Gninnorg/ThePreamp/Hardware/Controller/ThePreamp-Controller.jpg

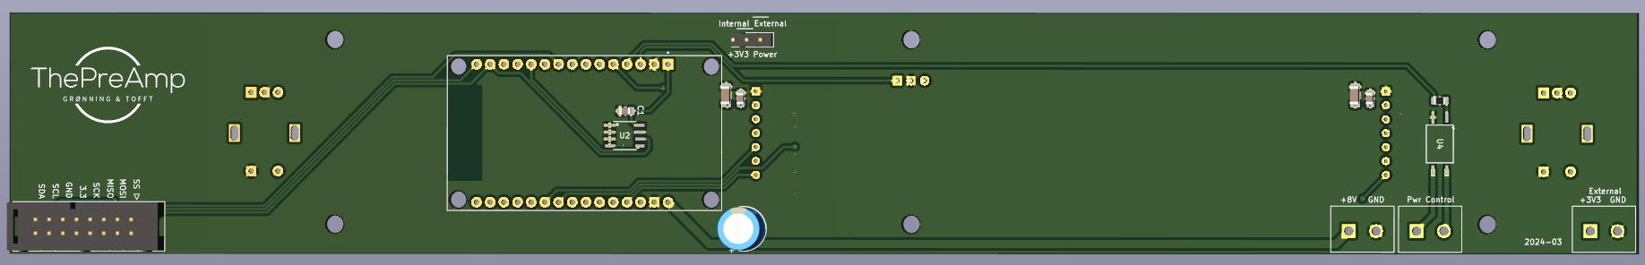
Hardware/Controller/ThePreamp-Controller.jpg
