Gninnorg/ThePreamp/Hardware/Analogue/ThePreamp-Analogue.jpg

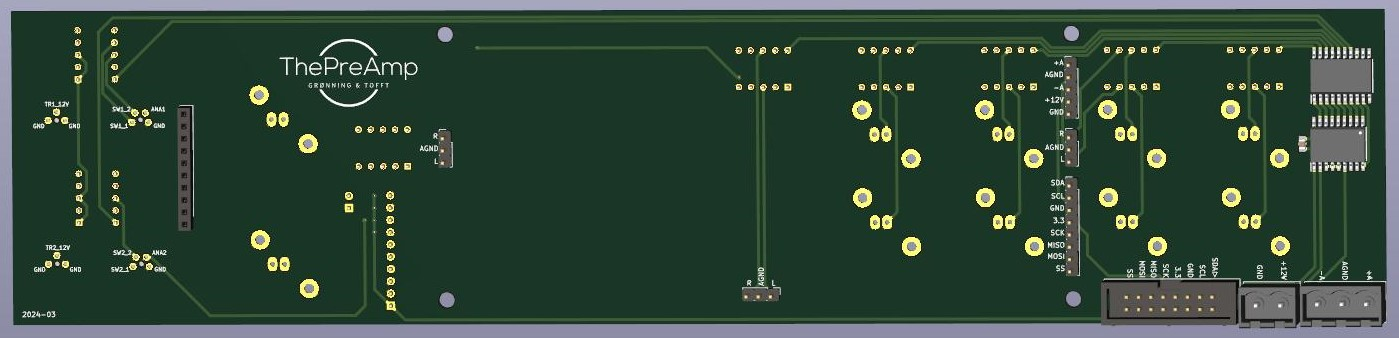
Hardware/Analogue/ThePreamp-Analogue.jpg
