Gninnorg/ThePreamp/Hardware/ThePreAmp.png

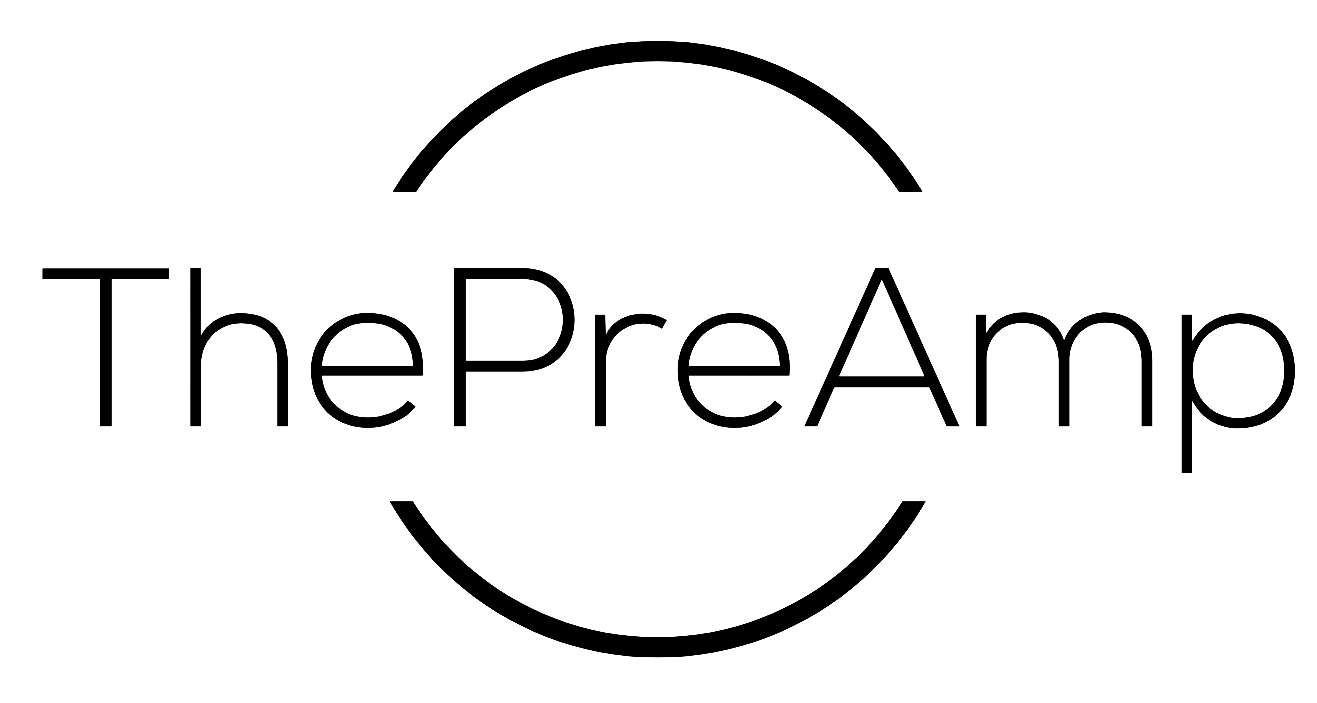
Hardware/ThePreAmp.png
