Gninnorg/ThePreamp/Software/ThePreAmp wifi QR BIG.bmp

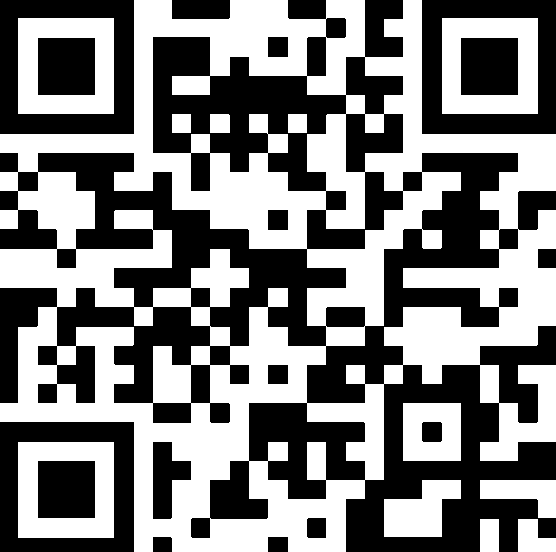
Software/ThePreAmp wifi QR BIG.bmp
