Gninnorg/ThePreamp/Software/Webpages/ThePreAmp.png

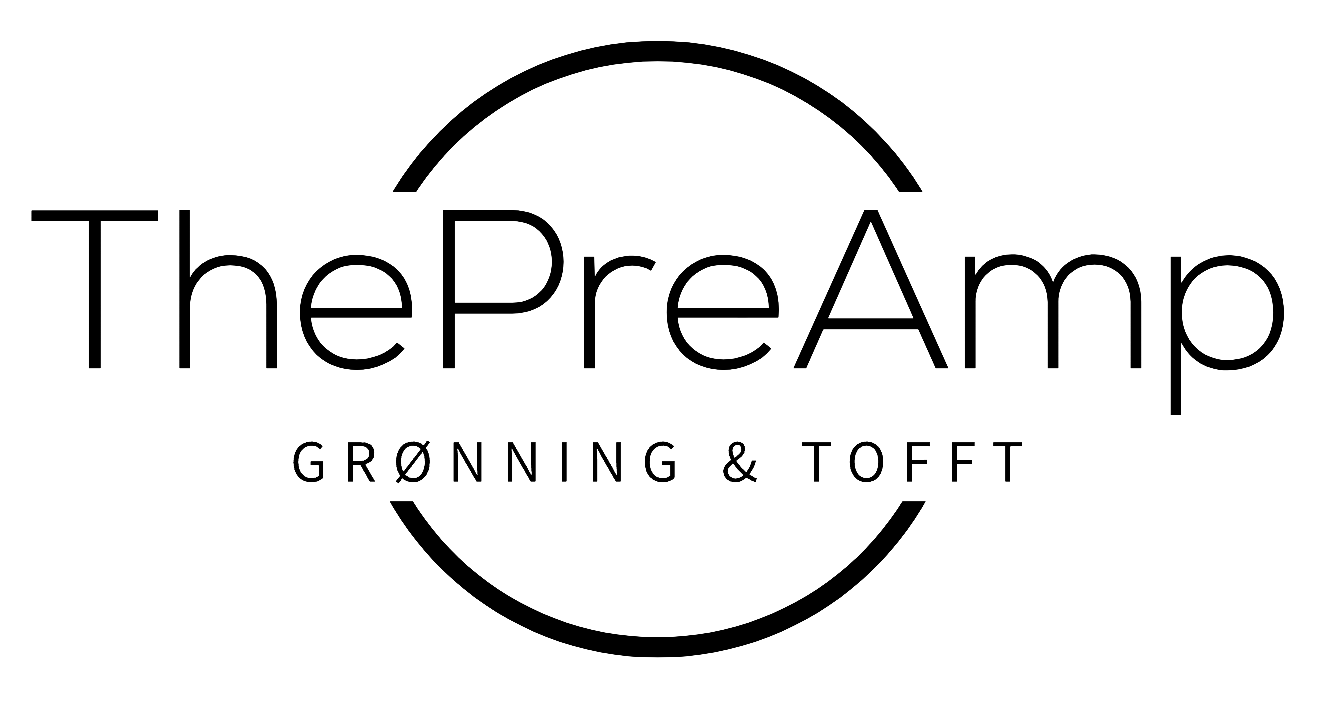
Software/Webpages/ThePreAmp.png
