Gninnorg/ThePreamp/Hardware/Analogue/THE_PREAMP_CONN_POWER_5_08/TBP01R1-508-02BK/BOM.txt

3DX_CUI_DEVICES_Supplier: CUI Devices
3DX_CUI_DEVICES_Part Number: TBP01R1-508-02BK
3DX_CUI_DEVICES_Description: TBP01R1-508 Series - 2 Poles, Pluggable, Receptacle, Horizontal, 5.08 Pitch, Terminal Block Connector, RoHS Compliant
