Gninnorg/ThePreamp/Hardware/Analogue/THE_PREAMP_CONN_POWER_5_08/TBP01R2-508-03BK/BOM.txt

3DX_CUI_DEVICES_Supplier: CUI Devices
3DX_CUI_DEVICES_Part Number: TBP01R2-508-03BK
3DX_CUI_DEVICES_Description: TBP01R2-508 Series - 3 Poles, Pluggable, Receptacle, Vertical, 5.08 Pitch, Terminal Block Connector, RoHS Compliant
