Gninnorg/ThePreamp/Hardware/Analogue/EA2-12NJ/EA2-12NJ.step

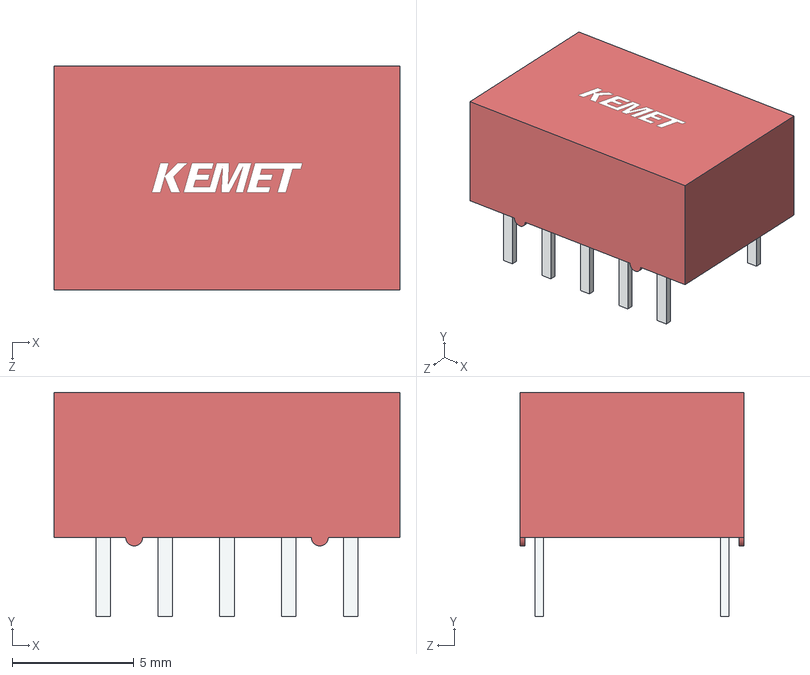
[picture p7: CAD file, 2024-02-28]
Hardware/Analogue/EA2-12NJ/EA2-12NJ.step
14.2 x 9.20 x 9.20 mm
