Gninnorg/ThePreamp/Hardware/Analogue/RCA_CONNECTOR_ALI/RCA Connector ALI.step

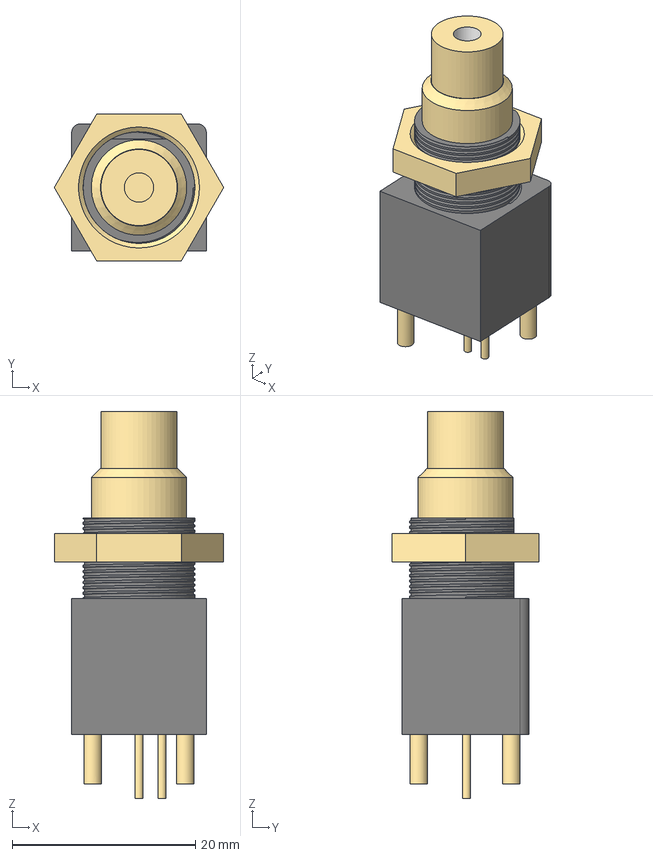
[picture p8: CAD file, 2024-03-03]
Hardware/Analogue/RCA_CONNECTOR_ALI/RCA Connector ALI.step
18.5 x 16.0 x 42.2 mm
