Gninnorg/ThePreamp/Hardware/Analogue/THE_PREAMP_CONN_POWER_5_08/TBP01R1-508-03BK/CUI_DEVICES_TBP01R1-508-03BK.step

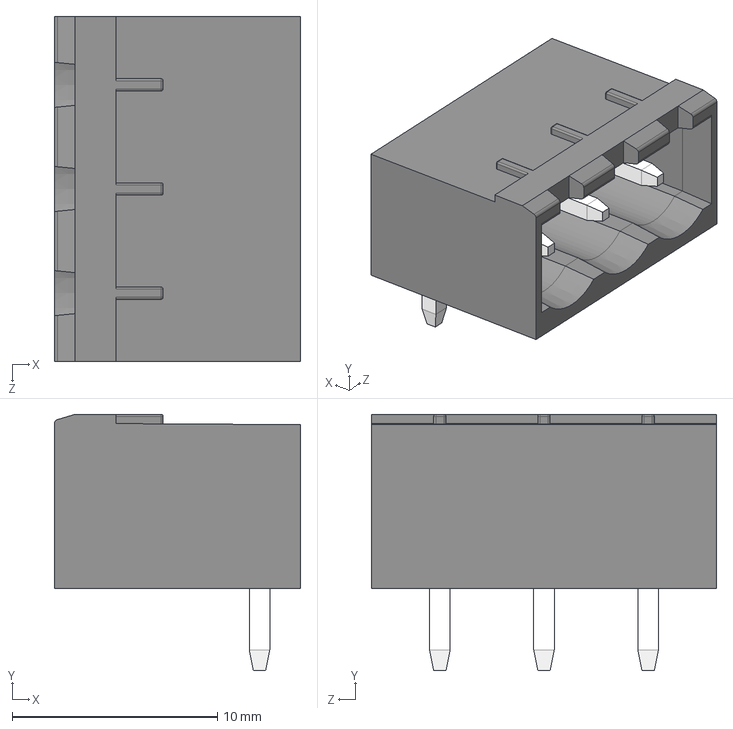
[picture p9: CAD file, 2024-02-27]
Hardware/Analogue/THE_PREAMP_CONN_POWER_5_08/TBP01R1-508-03BK/CUI_DEVICES_TBP01R1-508-03BK.step
12.0 x 12.5 x 16.8 mm
