Gninnorg/ThePreamp/Hardware/Analogue/THE_PREAMP_CONN_POWER_5_08/TBP01R2-508-03BK/CUI_DEVICES_TBP01R2-508-03BK.step

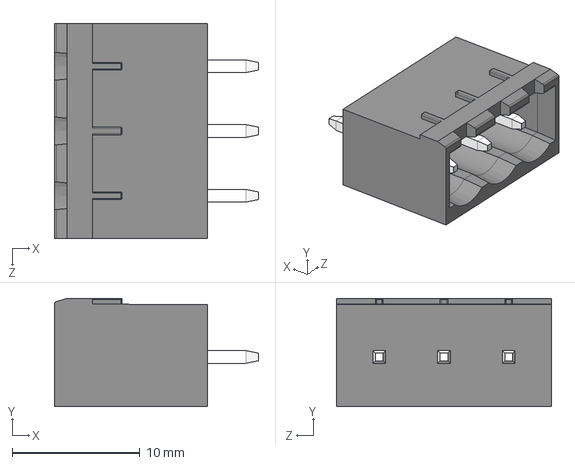
[picture p11: CAD file, 2024-02-27]
Hardware/Analogue/THE_PREAMP_CONN_POWER_5_08/TBP01R2-508-03BK/CUI_DEVICES_TBP01R2-508-03BK.step
16.0 x 8.50 x 16.8 mm
