Gninnorg/ThePreamp/Hardware/Analogue/ULN2803/ULN2803CDWR.STEP

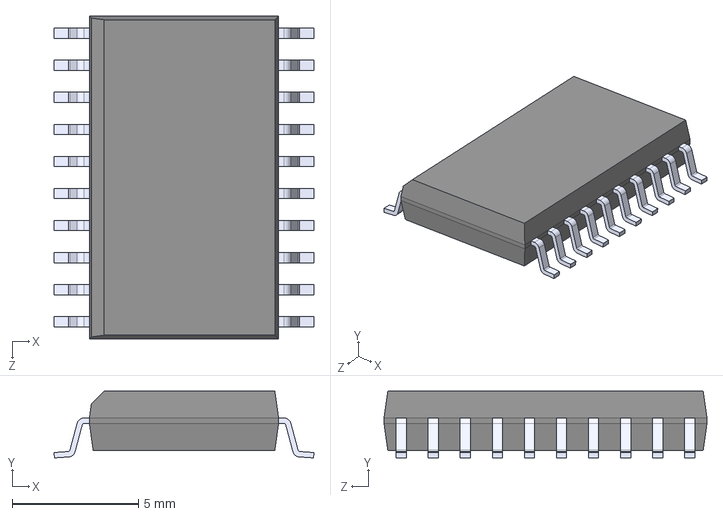
[picture p12: CAD file, 2024-02-28]
Hardware/Analogue/ULN2803/ULN2803CDWR.STEP
10.3 x 2.65 x 12.8 mm
