Gninnorg/ThePreamp/Hardware/Controller/EEE_FH1C471L/EEEFH1C471L.step

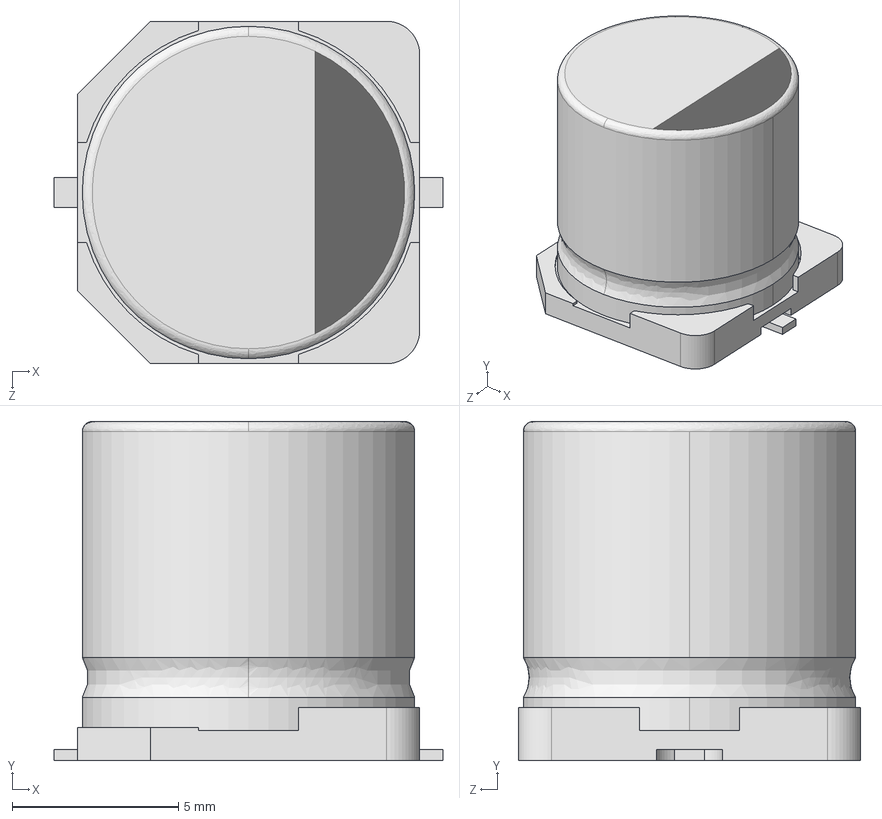
[picture p13: CAD file, 2024-02-11]
Hardware/Controller/EEE_FH1C471L/EEEFH1C471L.step
11.7 x 10.2 x 10.3 mm
