Gninnorg/ThePreamp/Hardware/Controller/PEC11R-4220F-S0024/PEC11r-4220f-s0024.stp

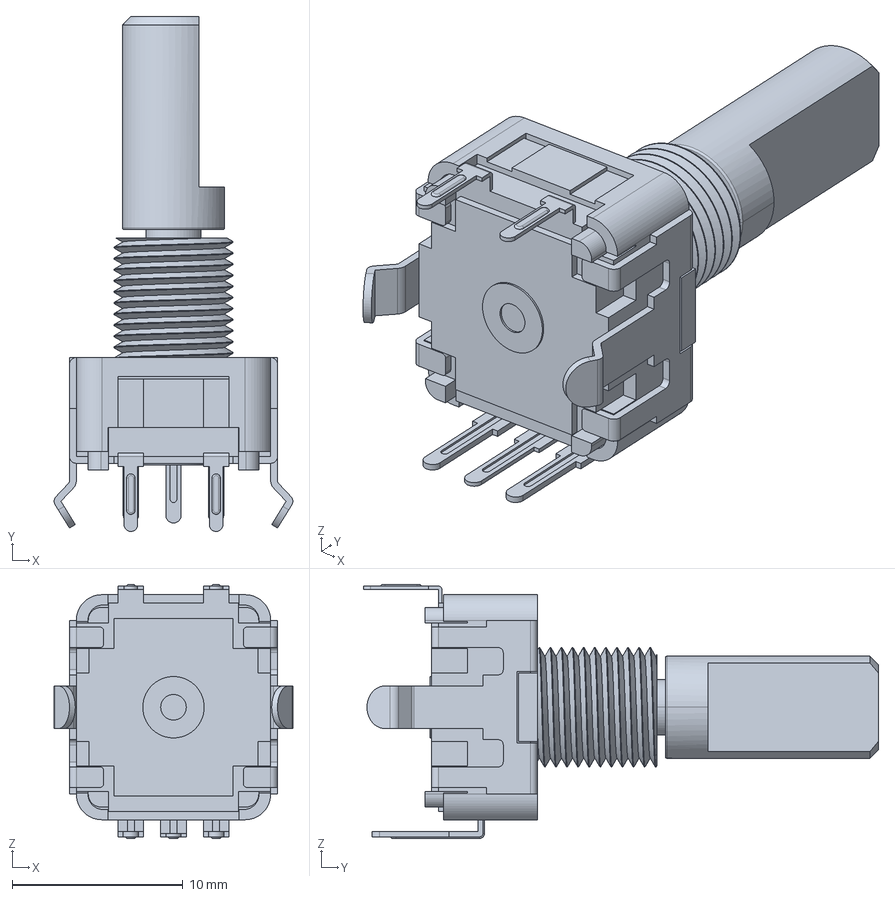
[picture p14: CAD file, 2024-03-03]
Hardware/Controller/PEC11R-4220F-S0024/PEC11r-4220f-s0024.stp
14.0 x 30.2 x 14.9 mm
