Gninnorg/ThePreamp/Hardware/Analogue/M8 connector/M8 3 pin/c-t4040014031-000-a-3d.stp

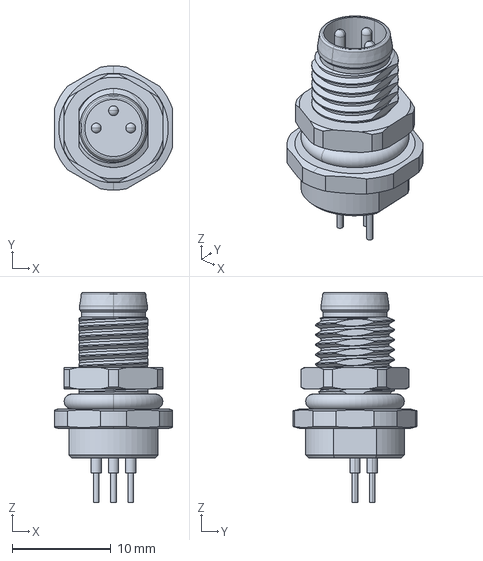
[picture p15: CAD file, 2024-02-28]
Hardware/Analogue/M8 connector/M8 3 pin/c-t4040014031-000-a-3d.stp
12.0 x 12.6 x 21.3 mm
