Gninnorg/ThePreamp/Hardware/Analogue/MCP23008/MCP23008-E_SO.step

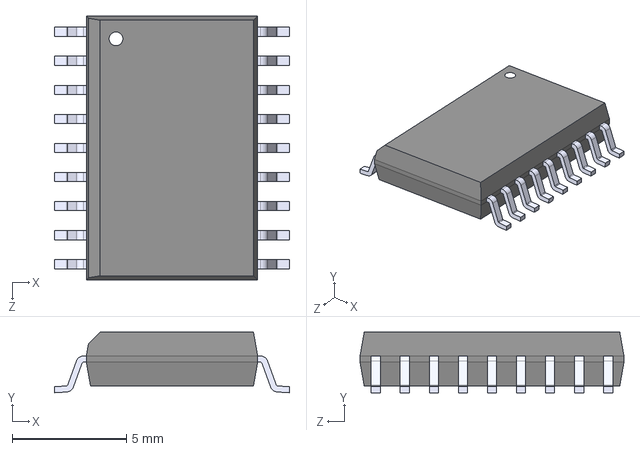
[picture p17: CAD file, 2024-02-28]
Hardware/Analogue/MCP23008/MCP23008-E_SO.step
10.3 x 2.65 x 11.5 mm
