Gninnorg/ThePreamp/Software/ThePreamp Controller/test/README

This directory is intended for PlatformIO Test Runner and project tests.

Unit Testing is a software testing method by which individual units of
source code, sets of one or more MCU program modules together with associated
control data, usage procedures, and operating procedures, are tested to
determine whether they are fit for use. Unit testing finds problems early
in the development cycle.

More information about PlatformIO Unit Testing:
- https://docs.platformio.org/en/latest/advanced/unit-testing/index.html

TO DO

Test IR - PASSED
Test rotary encoders - PASSED
Test SPI on analogue board (Muses) - PASSED
Test triggers 12V + Switch

IMPORTANT:
The SPI frequency for the SH1122 displays must be changed in u8x8_d_sh1122.c to 20000000 Hz:

static const u8x8_display_info_t u8x8_sh1122_256x64_display_info =
{
  /* chip_enable_level = */ 0,
  /* chip_disable_level = */ 1,
  
  /* post_chip_enable_wait_ns = */ 20,
  /* pre_chip_disable_wait_ns = */ 10,
  /* reset_pulse_width_ms = */ 10, 	/* sh1122: 10 us */
  /* post_reset_wait_ms = */ 20, 	/* */
  /* sda_setup_time_ns = */ 125,		/* sh1122: cycle time is 250ns, so use 250/2 */
  /* sck_pulse_width_ns = */ 125,	/* sh1122: cycle time is 250ns, so use 250/2 */
  /* sck_clock_hz = */ 20000000UL,	/* since Arduino 1.6.0, the SPI bus speed in Hz. Should be  1000000000/sck_pulse_width_ns  */
  /* spi_mode = */ 0,		/* active high, rising edge */
  /* i2c_bus_clock_100kHz = */ 4,
  /* data_setup_time_ns = */ 10,
  /* write_pulse_width_ns = */ 150,	/* sh1122: cycle time is 300ns, so use 300/2 = 150 */
  /* tile_width = */ 32,		/* 256 pixel, so we require 32 bytes for this */
  /* tile_height = */ 8,
  /* default_x_offset = */ 0,	/* this is the byte offset (there are two pixel per byte with 4 bit per pixel) */
  /* flipmode_x_offset = */ 0,
  /* pixel_width = */ 256,
  /* pixel_height = */ 64
};
