Gninnorg/ThePreamp/Hardware/Controller/ThePreamp-Controller.kicad_pcb

## KiCad design Hardware/Controller/ThePreamp-Controller.kicad_pcb (2026-02-25)

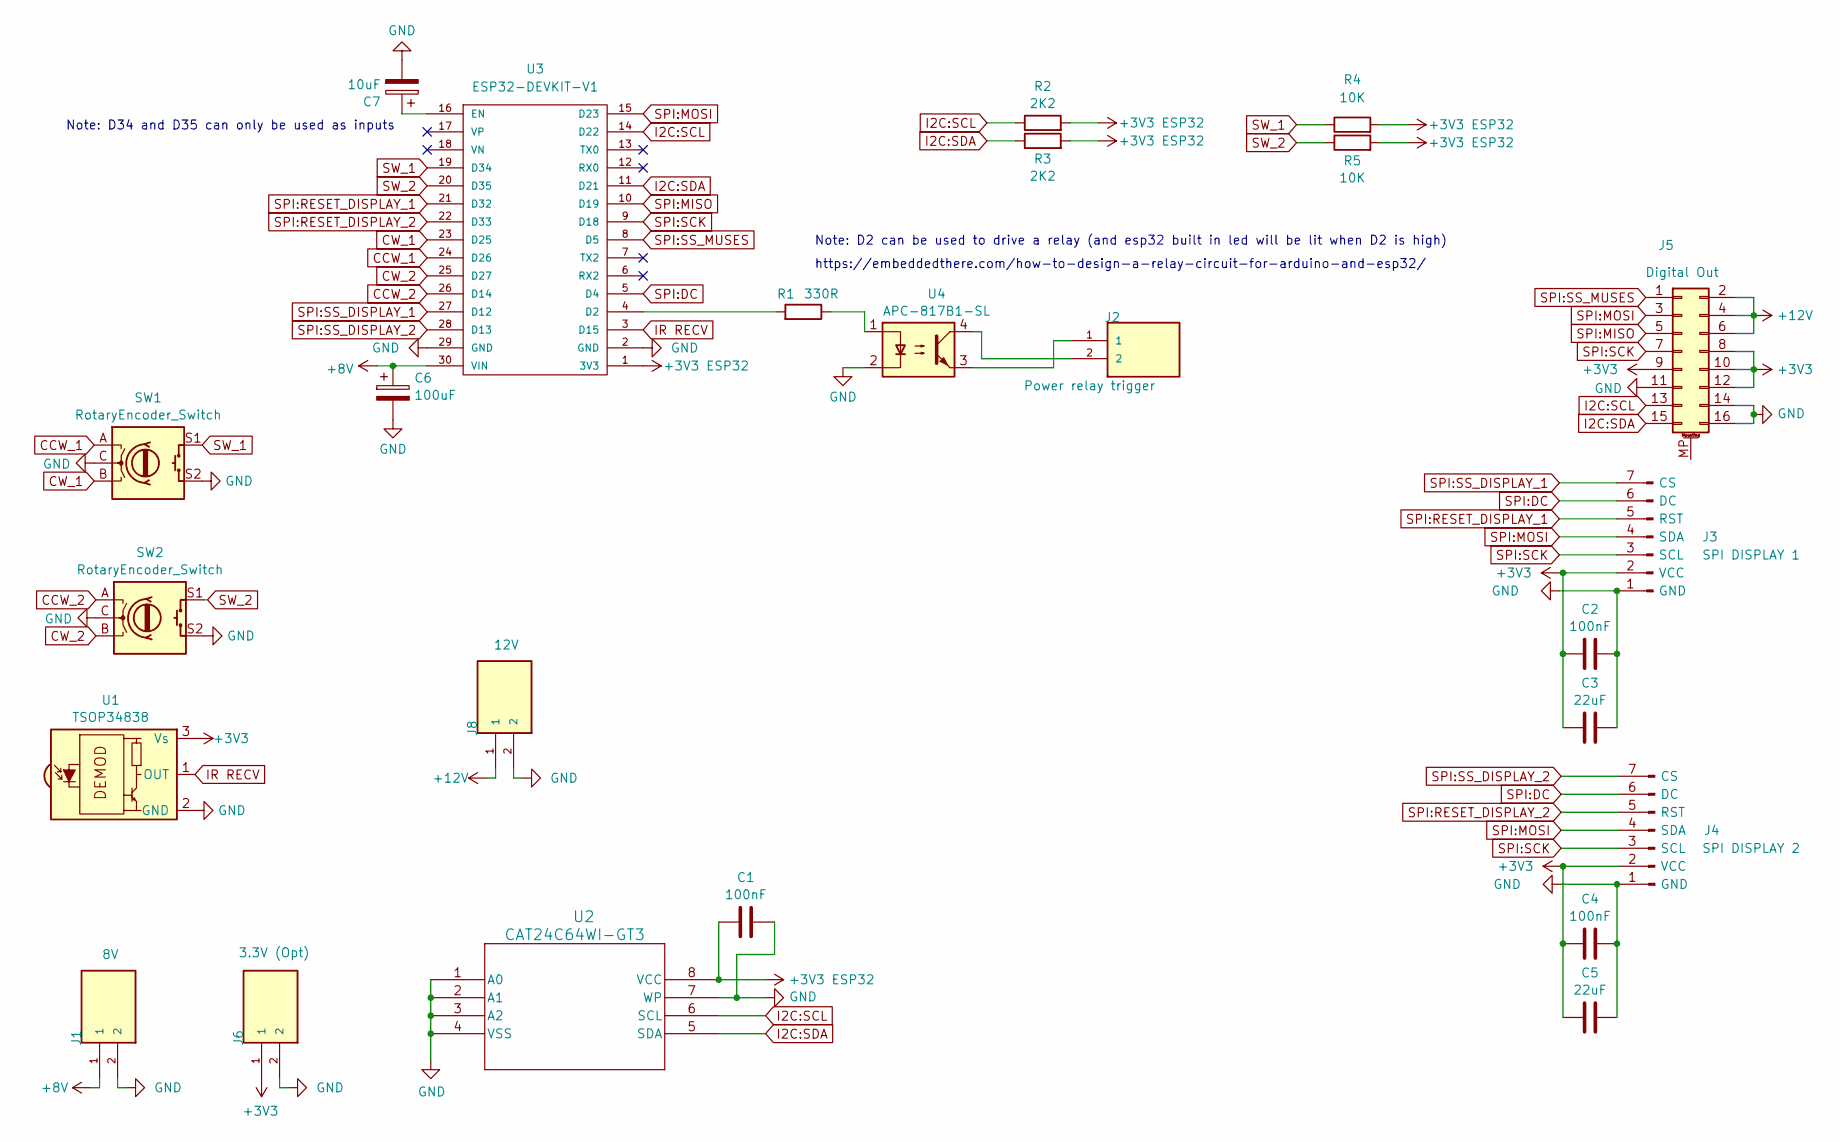
[picture p18: schematic ThePreamp-Controller.kicad_sch]

Parts:
C1, C2, C4: 100nF; C_0805_2012Metric_Pad1.18x1.45mm_HandSolder
C3, C5: 22uF; C_1206_3216Metric_Pad1.33x1.80mm_HandSolder
C6: 100uF; CP_Radial_D8.0mm_P3.50mm
C7: 10uF; CP_Radial_D8.0mm_P3.50mm
J1: 8V; TBP01R2-508-02BK (VERT)
J2: Power relay trigger; TBP01R2-508-02BK (VERT)
J3: SPI DISPLAY 1; OLED SPI 2.08
J4: SPI DISPLAY 2; OLED SPI 2.08
J5: Digital Out; IDC-Header_2x08_P2.54mm_Vertical
J6: 3.3V (Opt); TBP01R2-508-02BK (VERT)
J8: 12V; TBP01R2-508-02BK (VERT)
R1: 330R; R_0805_2012Metric_Pad1.20x1.40mm_HandSolder
R2, R3: 2K2; R_0805_2012Metric_Pad1.20x1.40mm_HandSolder
R4, R5: 10K; R_0805_2012Metric_Pad1.20x1.40mm_HandSolder
SW1, SW2: RotaryEncoder_Switch; RotaryEncoder_Alps_EC11E-Switch_Vertical_H20mm
U1: TSOP34838; Vishay_MOLD-3Pin
U2: CAT24C64WI-GT3; SOIC8_ONS-M
U3: ESP32-DEVKIT-V1; MODULE_ESP32_DEVKIT_V1; PARTREV N/A
U4: APC-817B1-SL; APC-817xx-SL_AMB-M

Connections:
+3V3: C2.1, C3.1, C4.1, C5.1, J3.2 (VCC), J4.2 (VCC), J5.8, J5.9, J5.10, J5.12, J6.1, U1.3 (Vs)
+3V3 ESP32: C1.1, R2.2, R3.2, R4.2, R5.2, U2.8 (VCC), U3.1 (3V3)
+8V: C6.1, J1.1, U3.30 (VIN)
+12V: J5.2, J5.4, J5.6, J8.1
CCW_1: SW1.A, U3.24 (D26)
CCW_2: SW2.A, U3.26 (D14)
CW_1: SW1.B, U3.23 (D25)
CW_2: SW2.B, U3.25 (D27)
GND: C1.2, C2.2, C3.2, C4.2, C5.2, C6.2, C7.2, J1.2, J3.1 (GND), J4.1 (GND), J5.11, J5.14, J5.16, J6.2, J8.2, SW1.C, SW1.S2, SW2.C, SW2.S2, U1.2 (GND), U2.1 (A0), U2.2 (A1), U2.3 (A2), U2.4 (VSS), U2.7 (WP), U3.2 (GND), U3.29 (GND), U4.2
I2C:SCL: J5.13, R2.1, U2.6 (SCL), U3.14 (D22)
I2C:SDA: J5.15, R3.1, U2.5 (SDA), U3.11 (D21)
IR RECV: U1.1 (OUT), U3.3 (D15)
unnamed: J2.1, U4.3
unnamed: J2.2, U4.4
unnamed: R1.1, U4.1
unnamed: R1.2, U3.4 (D2)
unnamed: C7.1, U3.16 (EN)
SPI:DC: J3.6 (DC), J4.6 (DC), U3.5 (D4)
SPI:MISO: J5.5, U3.10 (D19)
SPI:MOSI: J3.4 (SDA), J4.4 (SDA), J5.3, U3.15 (D23)
SPI:RESET_DISPLAY_1: J3.5 (RST), U3.21 (D32)
SPI:RESET_DISPLAY_2: J4.5 (RST), U3.22 (D33)
SPI:SCK: J3.3 (SCL), J4.3 (SCL), J5.7, U3.9 (D18)
SPI:SS_DISPLAY_1: J3.7 (CS), U3.27 (D12)
SPI:SS_DISPLAY_2: J4.7 (CS), U3.28 (D13)
SPI:SS_MUSES: J5.1, U3.8 (D5)
SW_1: R4.1, SW1.S1, U3.19 (D34)
SW_2: R5.1, SW2.S1, U3.20 (D35)

Notes on the sheet:
Note: D34 and D35 can only be used as inputs
https://embeddedthere.com/how-to-design-a-relay-circuit-for-arduino-and-esp32/
Note: D2 can be used to drive a relay (and esp32 built in led will be lit when D2 is high)

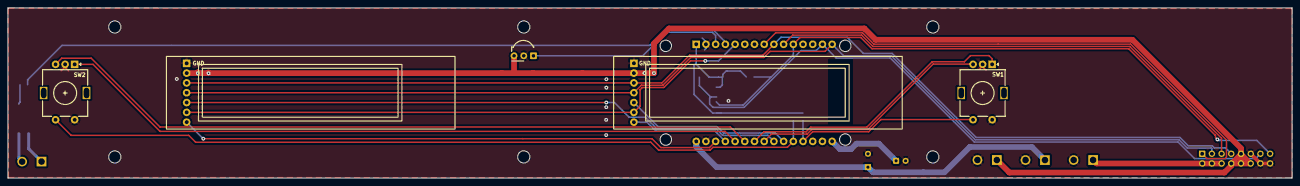
[picture p19: board ThePreamp-Controller.kicad_pcb from above]

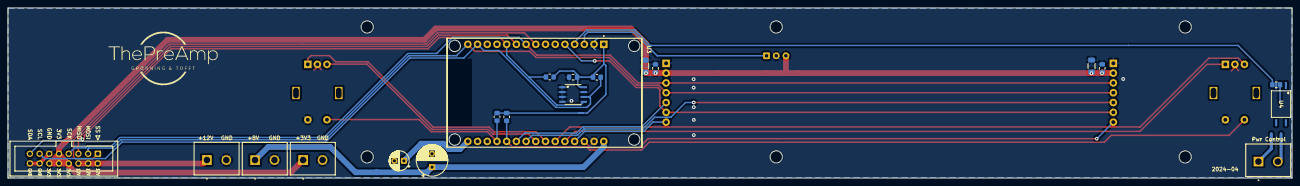
[picture p20: board ThePreamp-Controller.kicad_pcb from below]

Board: 2 copper layers, 335.9 x 44.5 mm, 31 parts (20 on the bottom side), 28 nets.

Other parts of the board:
 : MountingHole_3.2mm_M3_ISO7380
 #2,  #3,  #4,  #5,  #6: MountingHole_3.2mm_M3_ISO7380
