Gninnorg/ThePreamp/Hardware/Analogue/ThePreamp-Analogue.kicad_pcb

## KiCad design Hardware/Analogue/ThePreamp-Analogue.kicad_pcb (2026-02-15)

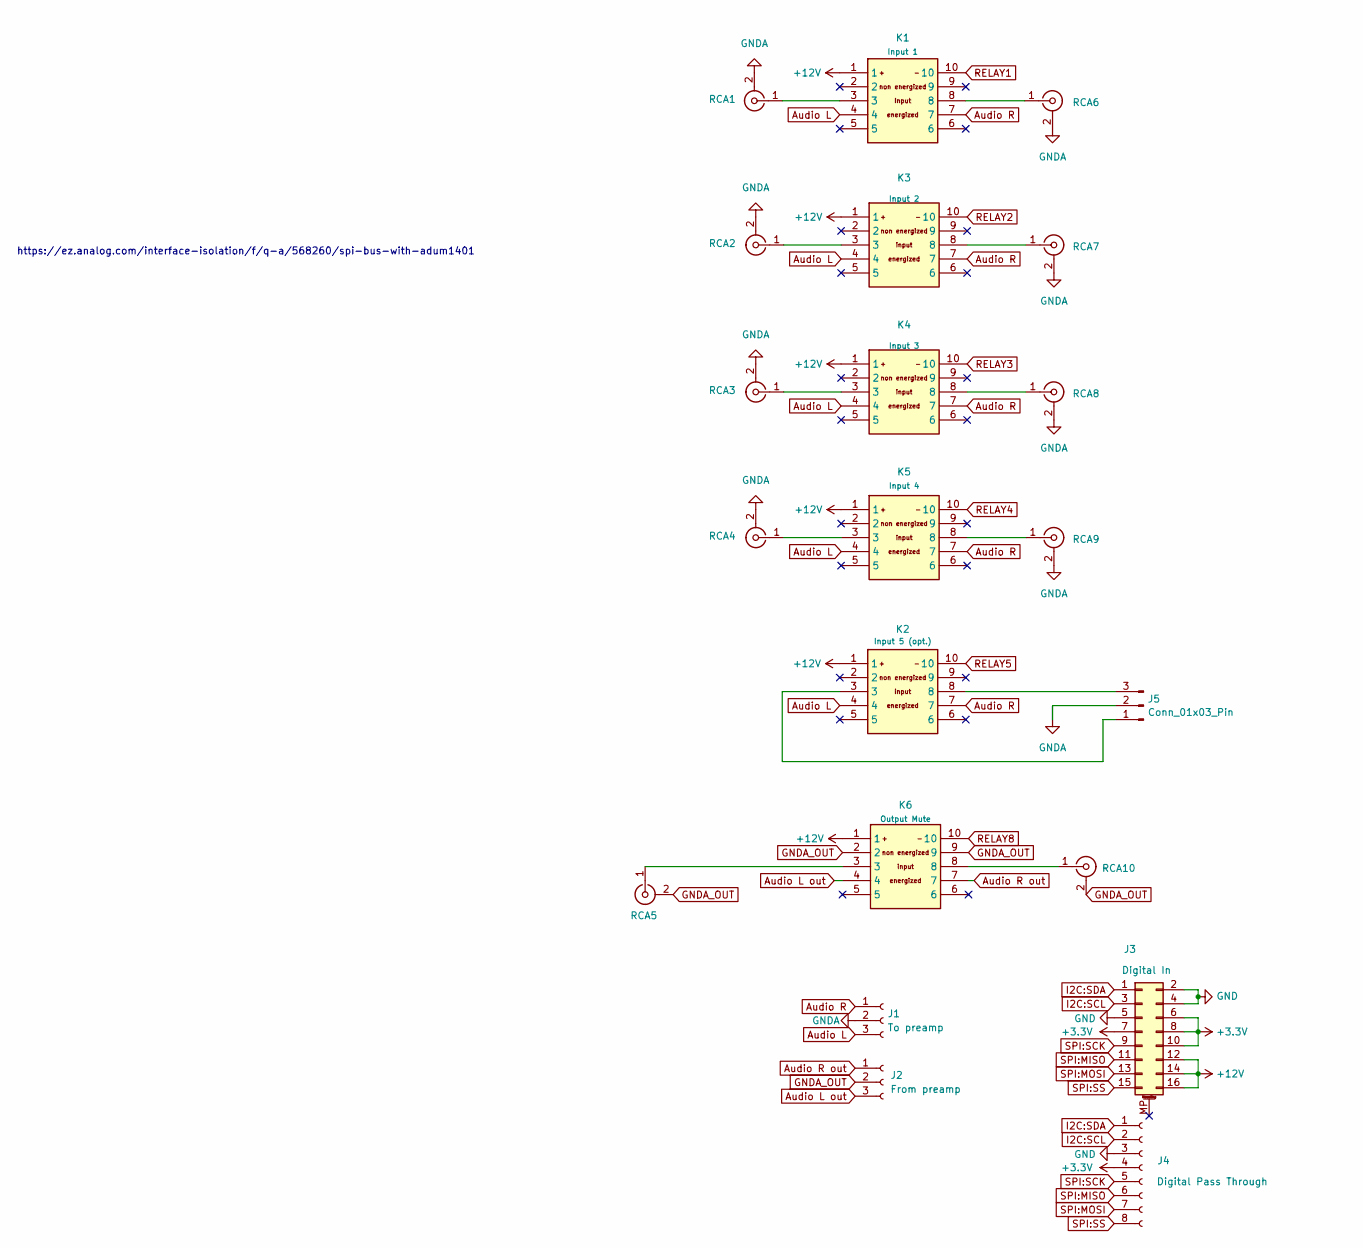
[picture p21: schematic ThePreamp-Analogue.kicad_sch, part in row 1, column 1]

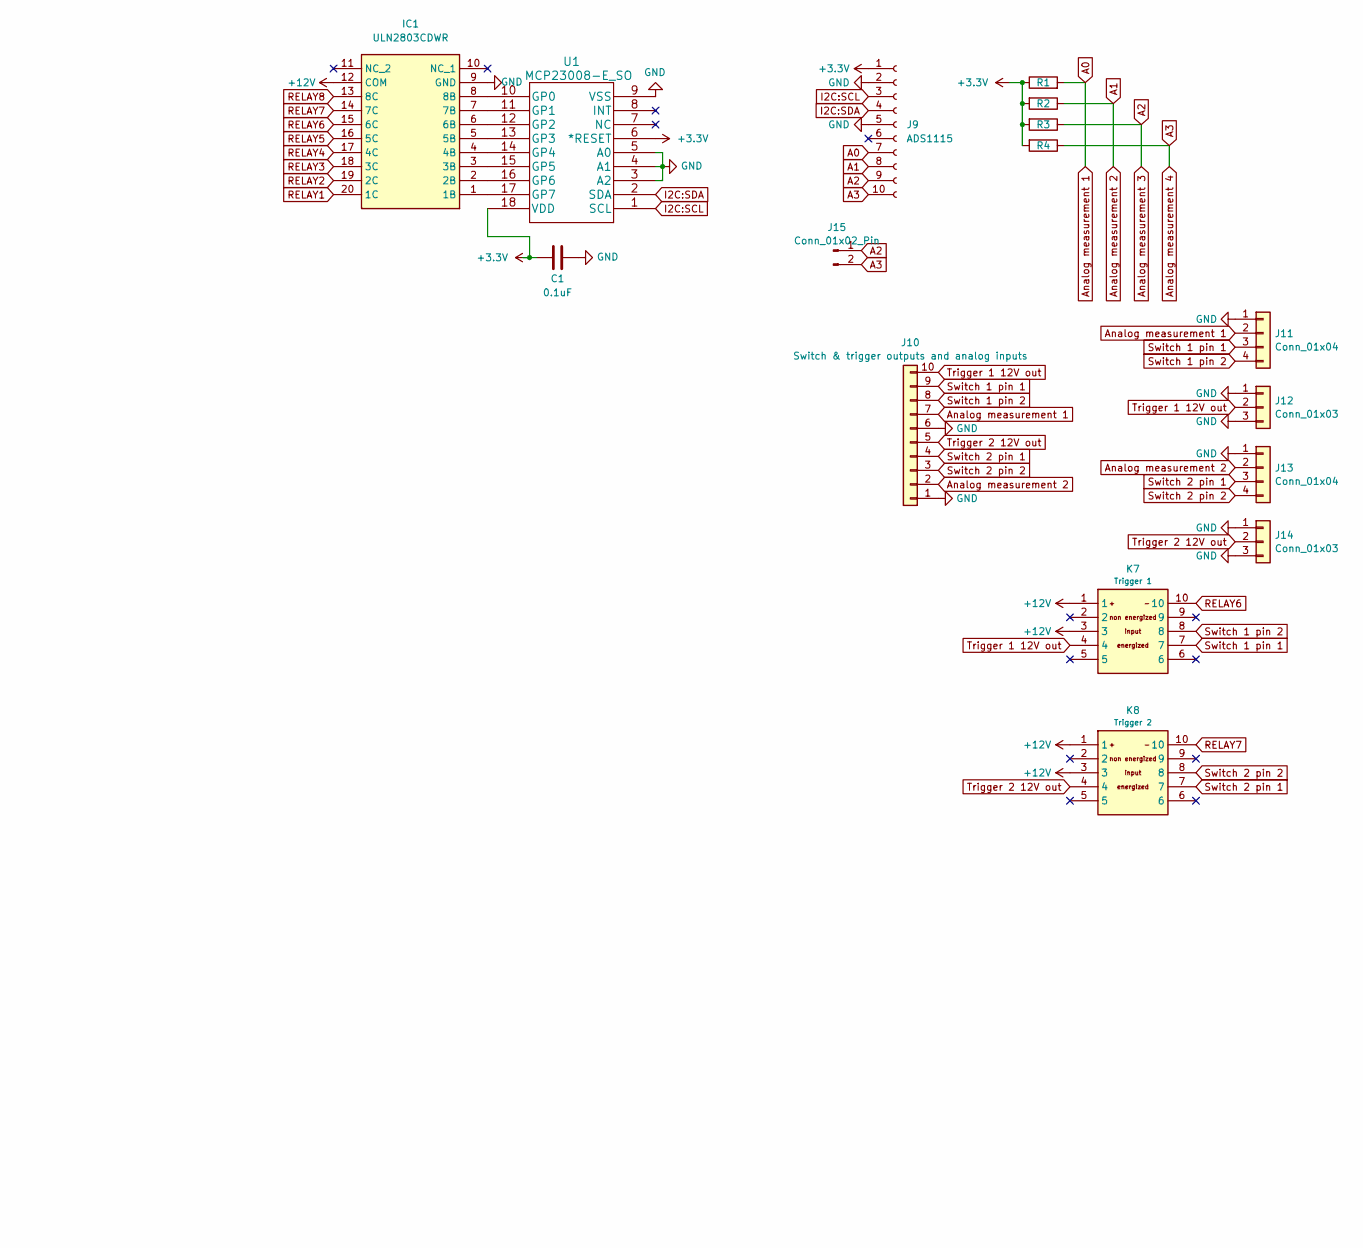
[picture p22: schematic ThePreamp-Analogue.kicad_sch, part in row 1, column 2]

Parts:
C1: 0.1uF; C_0805_2012Metric_Pad1.18x1.45mm_HandSolder
IC1: ULN2803CDWR; SOIC127P1030X265-20N; Mouser Part Number 595-ULN2803CDWR
J1: To preamp; PinSocket_1x03_P2.54mm_Vertical
J2: From preamp; PinSocket_1x03_P2.54mm_Vertical
J3: Digital In; IDC-Header_2x08_P2.54mm_Vertical
J4: Digital Pass Through; PinSocket_1x08_P2.54mm_Vertical
J5: Conn_01x03_Pin; PinHeader_1x03_P2.54mm_Vertical
J9: ADS1115; PinHeader_1x10_P2.54mm_Vertical
J10: Switch & trigger outputs and analog inputs; PinSocket_1x10_P2.54mm_Vertical
J11, J13: Conn_01x04; M8 4 pin
J12, J14: Conn_01x03; M8 3 pin
J15: Conn_01x02_Pin; PinHeader_1x02_P2.54mm_Vertical
K1: Input 1; DIPS762W60P254L1420H630Q10N; Manufacturer_Part_Number EA2-12NJ; Mouser Part Number 551-EA2-12NJ
K2: Input 5 (opt.); DIPS762W60P254L1420H630Q10N; Manufacturer_Part_Number EA2-12NJ; Mouser Part Number 551-EA2-12NJ
K3: Input 2; DIPS762W60P254L1420H630Q10N; Manufacturer_Part_Number EA2-12NJ; Mouser Part Number 551-EA2-12NJ
K4: Input 3; DIPS762W60P254L1420H630Q10N; Manufacturer_Part_Number EA2-12NJ; Mouser Part Number 551-EA2-12NJ
K5: Input 4; DIPS762W60P254L1420H630Q10N; Manufacturer_Part_Number EA2-12NJ; Mouser Part Number 551-EA2-12NJ
K6: Output Mute; DIPS762W60P254L1420H630Q10N; Manufacturer_Part_Number EA2-12NJ; Mouser Part Number 551-EA2-12NJ
K7: Trigger 1; DIPS762W60P254L1420H630Q10N; Manufacturer_Part_Number EA2-12NJ; Mouser Part Number 551-EA2-12NJ
K8: Trigger 2; DIPS762W60P254L1420H630Q10N; Manufacturer_Part_Number EA2-12NJ; Mouser Part Number 551-EA2-12NJ
R1, R2, R3, R4: 10K; R_0805_2012Metric_Pad1.20x1.40mm_HandSolder
RCA1, RCA2, RCA3, RCA4, RCA5, RCA6, RCA7, RCA8, RCA9, RCA10: RCA_Connector_ALI; RCA Connector ALI
U1: MCP23008-E_SO; SOIC127P1030X265-18N

Connections:
+3.3V: C1.1, J3.6, J3.7, J3.8, J3.10, J4.4, J9.1, R1.1, R2.2, R3.2, R4.2, U1.6 (*RESET), U1.18 (VDD)
+12V: IC1.12 (COM), J3.12, J3.14, J3.16, K1.1, K2.1, K3.1, K4.1, K5.1, K6.1, K7.1, K7.3, K8.1, K8.3
A0: J9.7, J10.7, J11.2, R1.2
A1: J9.8, J10.2, J13.2, R2.1
A2: J9.9, J15.1, R3.1
A3: J9.10, J15.2, R4.1
Audio L: J1.3, K1.4, K2.4, K3.4, K4.4, K5.4
Audio L out: J2.3, K6.4
Audio R: J1.1, K1.7, K2.7, K3.7, K4.7, K5.7
Audio R out: J2.1, K6.7
GND: C1.2, IC1.9 (GND), J3.2, J3.4, J3.5, J4.3, J9.2, J9.5, J10.1, J10.6, J11.1, J12.1, J12.3, J13.1, J14.1, J14.3, U1.3 (A2), U1.4 (A1), U1.5 (A0), U1.9 (VSS)
GNDA: J1.2, J5.2, RCA1.2 (Ext), RCA2.2 (Ext), RCA3.2 (Ext), RCA4.2 (Ext), RCA6.2 (Ext), RCA7.2 (Ext), RCA8.2 (Ext), RCA9.2 (Ext)
GNDA_OUT: J2.2, K6.2, K6.9, RCA5.2 (Ext), RCA10.2 (Ext)
I2C:SCL: J3.3, J4.2, J9.3, U1.1 (SCL)
I2C:SDA: J3.1, J4.1, J9.4, U1.2 (SDA)
unnamed: IC1.1 (1B), U1.17 (GP7)
unnamed: IC1.2 (2B), U1.16 (GP6)
unnamed: IC1.3 (3B), U1.15 (GP5)
unnamed: IC1.4 (4B), U1.14 (GP4)
unnamed: IC1.5 (5B), U1.13 (GP3)
unnamed: IC1.6 (6B), U1.12 (GP2)
unnamed: IC1.7 (7B), U1.11 (GP1)
unnamed: IC1.8 (8B), U1.10 (GP0)
unnamed: J5.1, K2.3
unnamed: J5.3, K2.8
unnamed: K1.3, RCA1.1 (In)
unnamed: K3.3, RCA2.1 (In)
unnamed: K4.3, RCA3.1 (In)
unnamed: K5.3, RCA4.1 (In)
unnamed: K6.3, RCA5.1 (In)
unnamed: K1.8, RCA6.1 (In)
unnamed: K3.8, RCA7.1 (In)
unnamed: K4.8, RCA8.1 (In)
unnamed: K5.8, RCA9.1 (In)
unnamed: K6.8, RCA10.1 (In)
RELAY1: IC1.20 (1C), K1.10
RELAY2: IC1.19 (2C), K3.10
RELAY3: IC1.18 (3C), K4.10
RELAY4: IC1.17 (4C), K5.10
RELAY5: IC1.16 (5C), K2.10
RELAY6: IC1.15 (6C), K7.10
RELAY7: IC1.14 (7C), K8.10
RELAY8: IC1.13 (8C), K6.10
SPI:MISO: J3.11, J4.6
SPI:MOSI: J3.13, J4.7
SPI:SCK: J3.9, J4.5
SPI:SS: J3.15, J4.8
Switch 1 pin 1: J10.9, J11.3, K7.7
Switch 1 pin 2: J10.8, J11.4, K7.8
Switch 2 pin 1: J10.4, J13.3, K8.7
Switch 2 pin 2: J10.3, J13.4, K8.8
Trigger 1 12V out: J10.10, J12.2, K7.4
Trigger 2 12V out: J10.5, J14.2, K8.4

Notes on the sheet:
https://ez.analog.com/interface-isolation/f/q-a/568260/spi-bus-with-adum1401

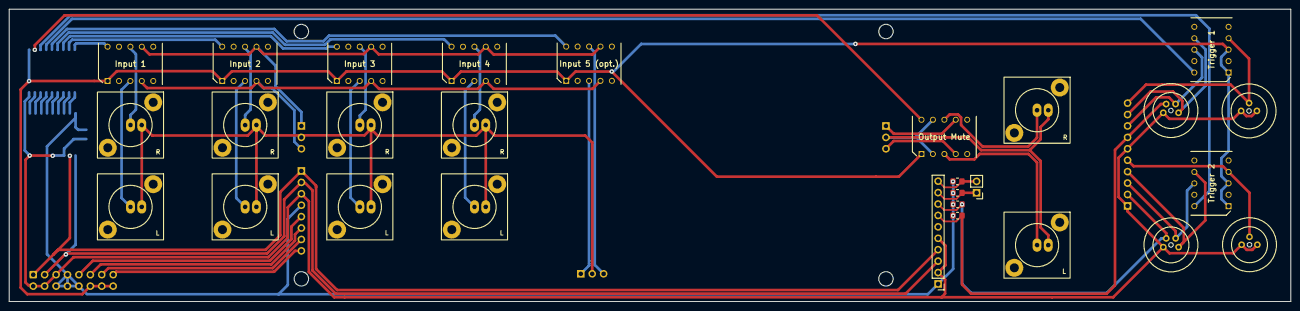
[picture p23: board ThePreamp-Analogue.kicad_pcb from above]

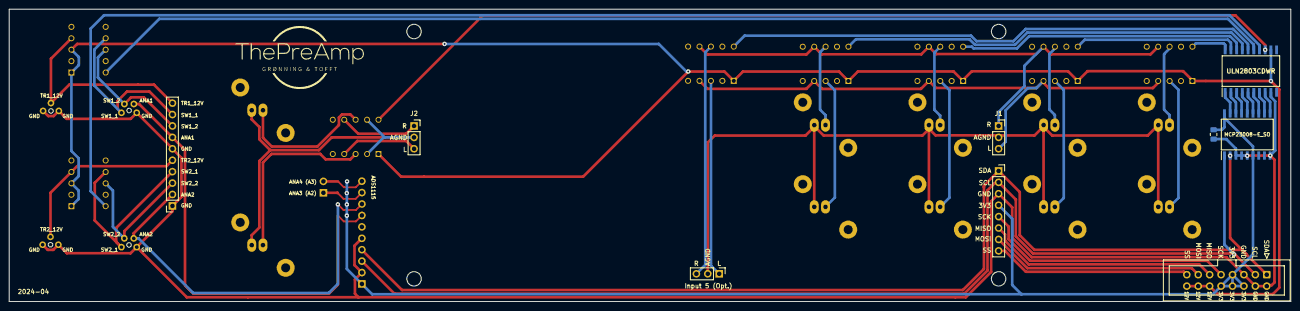
[picture p24: board ThePreamp-Analogue.kicad_pcb from below]

Board: 2 copper layers, 285.0 x 65.0 mm, 37 parts (9 on the bottom side), 53 nets.
