Gninnorg/ThePreamp/Hardware/Analogue/Daughter-Board-Muses-Op-Amp/Daughter-Board-Muses-Op-Amp.kicad_pcb

## KiCad design Hardware/Analogue/Daughter-Board-Muses-Op-Amp/Daughter-Board-Muses-Op-Amp.kicad_pcb (2024-10-31)

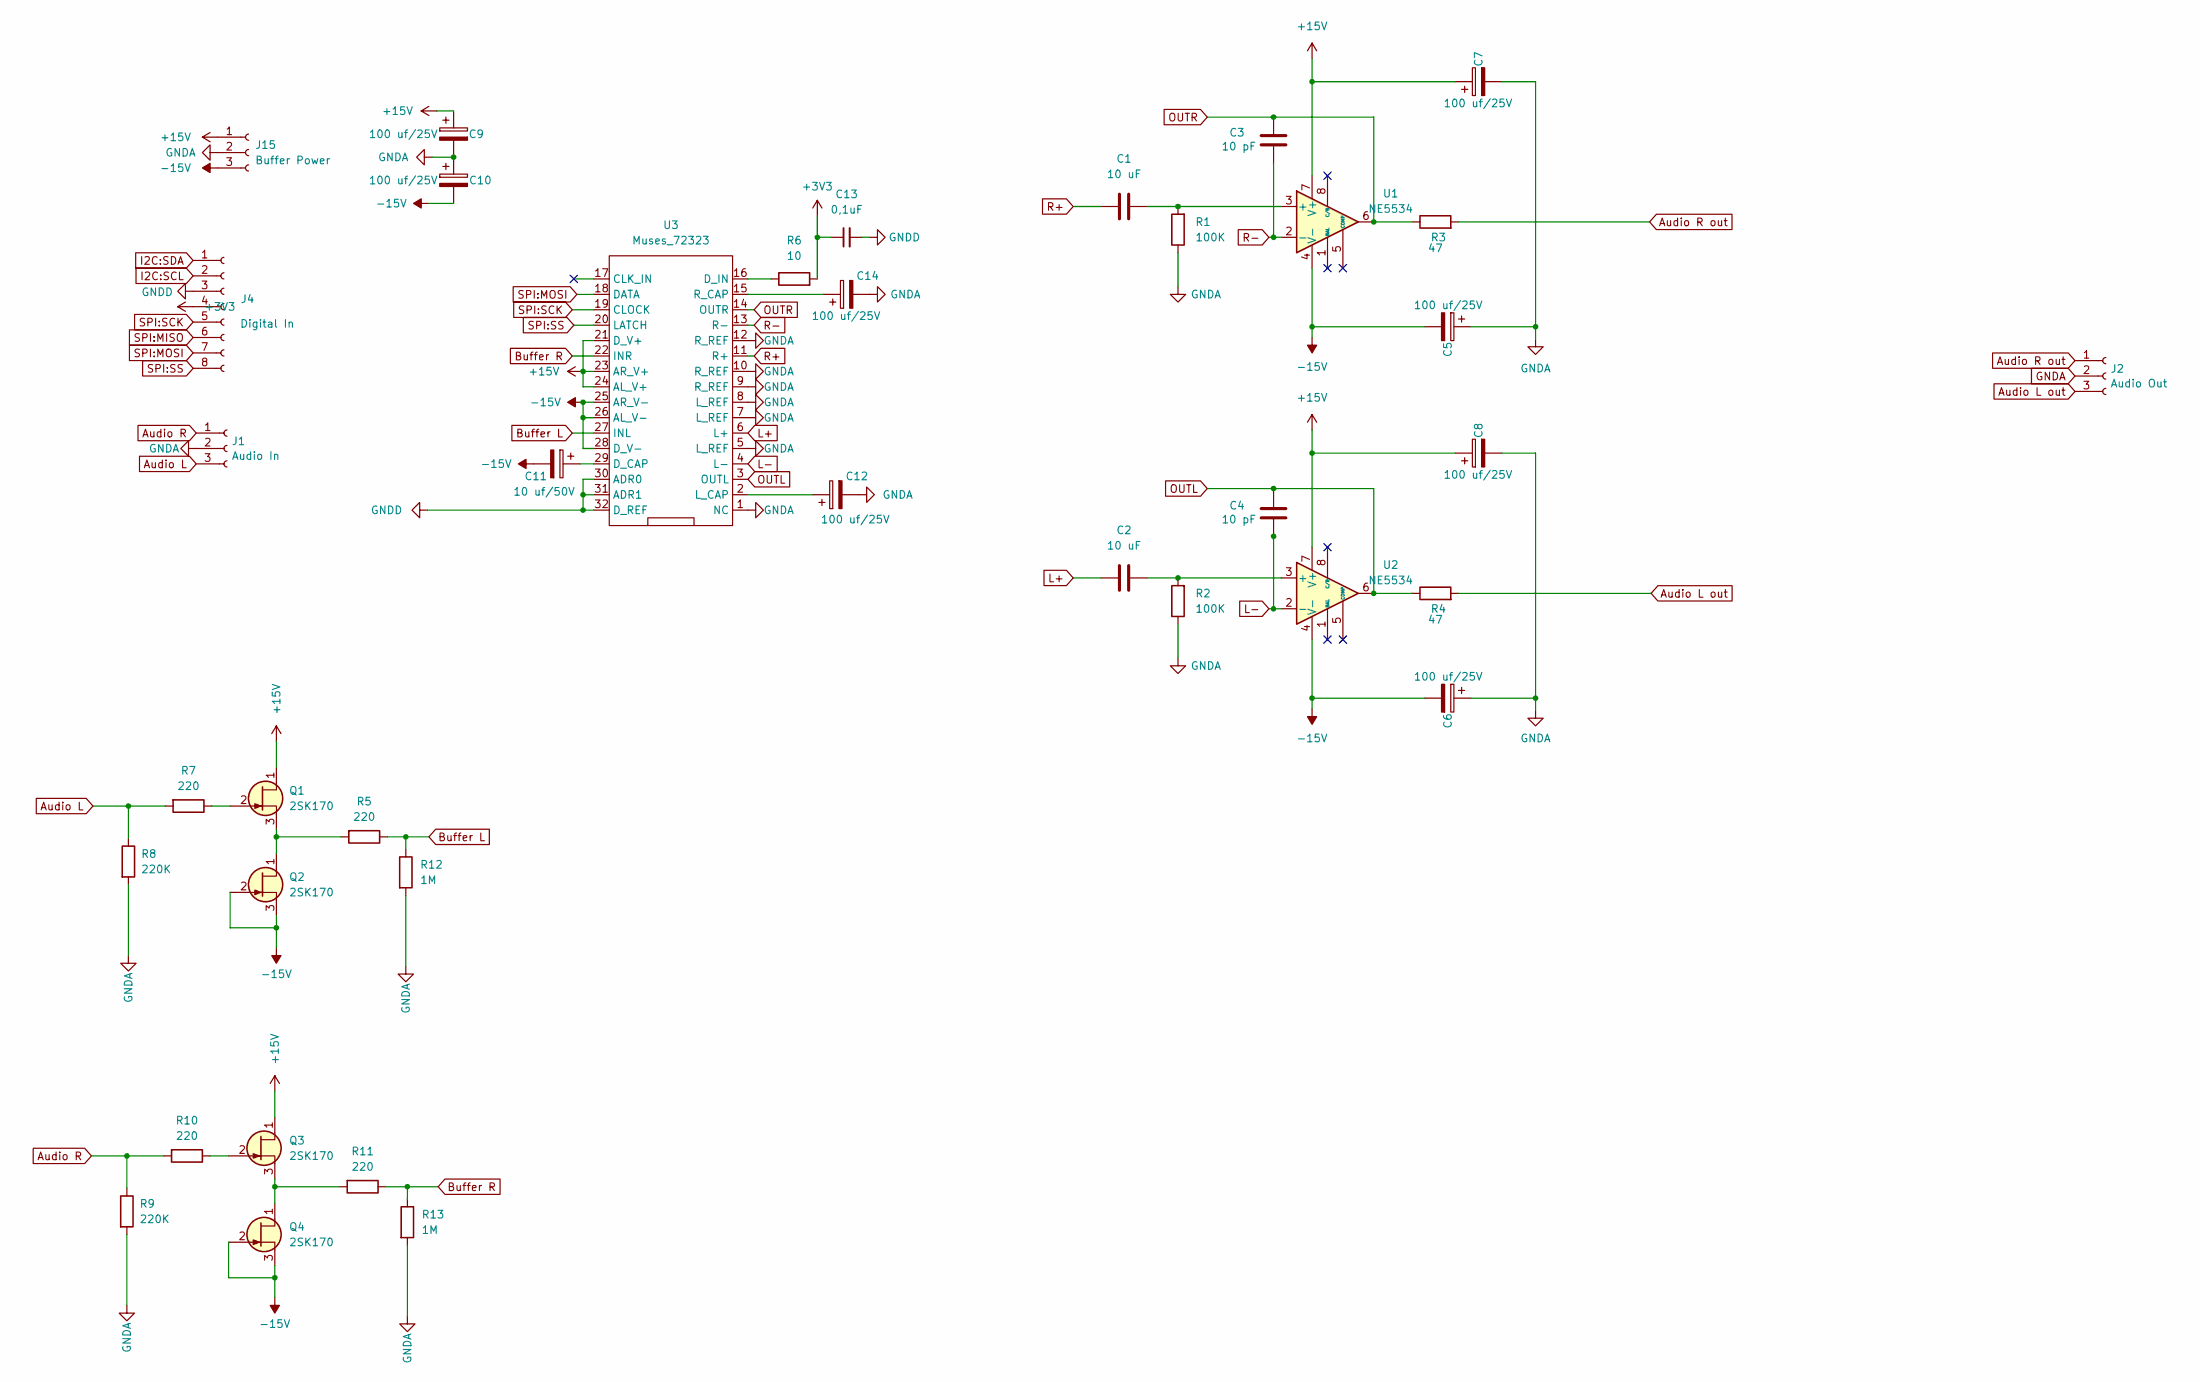
[picture p25: schematic Daughter-Board-Muses-Op-Amp.kicad_sch]

Parts:
C1, C2: 10 uF; CP_Radial_D5.0mm_P2.00mm
C3, C4: 10 pF; C_0805_2012Metric_Pad1.18x1.45mm_HandSolder
C5, C6, C7, C8, C9, C10, C12, C14: 100 uf/25V; CP_Radial_D8.0mm_P3.50mm
C11: 10 uf/50V; CP_Radial_D5.0mm_P2.00mm
C13: 0,1uF; C_0805_2012Metric_Pad1.18x1.45mm_HandSolder
J1: Audio In; PinHeader_1x03_P2.54mm_Vertical
J2: Audio Out; PinHeader_1x03_P2.54mm_Vertical
J4: Digital In; PinHeader_1x08_P2.54mm_Vertical
J15: Buffer Power; PinHeader_1x03_P2.54mm_Vertical
Q1, Q2, Q3, Q4: 2SK170; TO-92_HandSolder
R1, R2: 100K; R_0805_2012Metric_Pad1.20x1.40mm_HandSolder
R3, R4: 47; R_0805_2012Metric_Pad1.20x1.40mm_HandSolder
R5, R7, R10, R11: 220; R_0805_2012Metric_Pad1.20x1.40mm_HandSolder
R6: 10; R_0805_2012Metric_Pad1.20x1.40mm_HandSolder
R8, R9: 220K; R_0805_2012Metric_Pad1.20x1.40mm_HandSolder
R12, R13: 1M; R_0805_2012Metric_Pad1.20x1.40mm_HandSolder
U1, U2: NE5534; DIP-8_W7.62mm_Socket_LongPads
U3: Muses_72323; TSSOP-32_6.1x11mm_P0.65mm

Connections:
+3V3: C13.1, J4.4, R6.2
+15V: C7.1, C8.1, C9.1, J15.1, Q1.1 (D), Q3.1 (D), U1.7 (V+), U2.7 (V+), U3.21 (D_V+), U3.23 (AR_V+), U3.24 (AL_V+)
-15V: C5.2, C6.2, C10.2, C11.2, J15.3, Q2.2 (G), Q2.3 (S), Q4.2 (G), Q4.3 (S), U1.4 (V-), U2.4 (V-), U3.25 (AR_V-), U3.26 (AL_V-), U3.28 (D_V-)
Audio L: J1.3, R7.2, R8.1
Audio L out: J2.3, R4.2
Audio R: J1.1, R9.1, R10.2
Audio R out: J2.1, R3.2
Buffer L: R5.1, R12.1, U3.27 (INL)
Buffer R: R11.1, R13.1, U3.22 (INR)
GNDA: C5.1, C6.1, C7.2, C8.2, C9.2, C10.1, C12.2, C14.2, J1.2, J2.2, J15.2, R1.1, R2.1, R8.2, R9.2, R12.2, R13.2, U3.1 (NC), U3.5 (L_REF), U3.7 (L_REF), U3.8 (L_REF), U3.9 (R_REF), U3.10 (R_REF), U3.12 (R_REF)
GNDD: C13.2, J4.3, U3.30 (ADR0), U3.31 (ADR1), U3.32 (D_REF)
I2C:SCL: J4.2
I2C:SDA: J4.1
L+: C2.1, U3.6 (L+)
L-: C4.2, U2.2 (-), U3.4 (L-)
unnamed: Q1.2 (G), R7.1
unnamed: Q1.3 (S), Q2.1 (D), R5.2
unnamed: Q3.2 (G), R10.1
unnamed: Q3.3 (S), Q4.1 (D), R11.2
unnamed: C1.2, R1.2, U1.3 (+)
unnamed: C2.2, R2.2, U2.3 (+)
unnamed: C11.1, U3.29 (D_CAP)
unnamed: R6.1, U3.16 (D_IN)
unnamed: C12.1, U3.2 (L_CAP)
unnamed: C14.1, U3.15 (R_CAP)
OUTL: C4.1, R4.1, U2.6, U3.3 (OUTL)
OUTR: C3.1, R3.1, U1.6, U3.14 (OUTR)
R+: C1.1, U3.11 (R+)
R-: C3.2, U1.2 (-), U3.13 (R-)
SPI:MISO: J4.6
SPI:MOSI: J4.7, U3.18 (DATA)
SPI:SCK: J4.5, U3.19 (CLOCK)
SPI:SS: J4.8, U3.20 (LATCH)

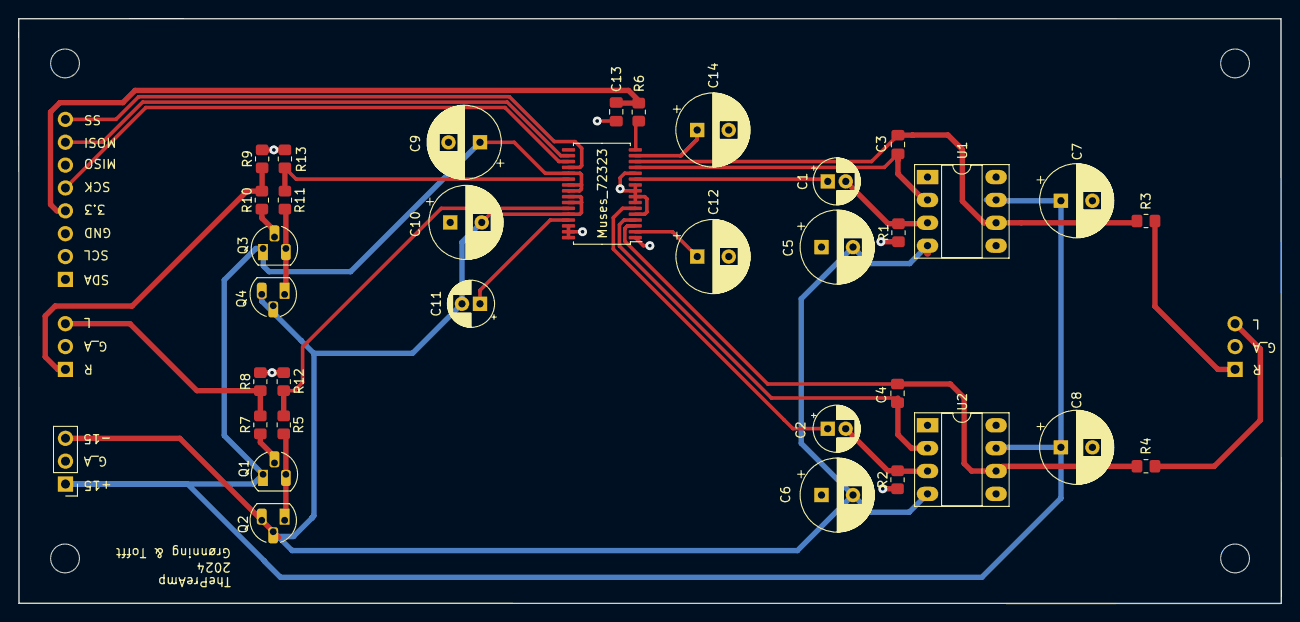
[picture p26: board Daughter-Board-Muses-Op-Amp.kicad_pcb from above]

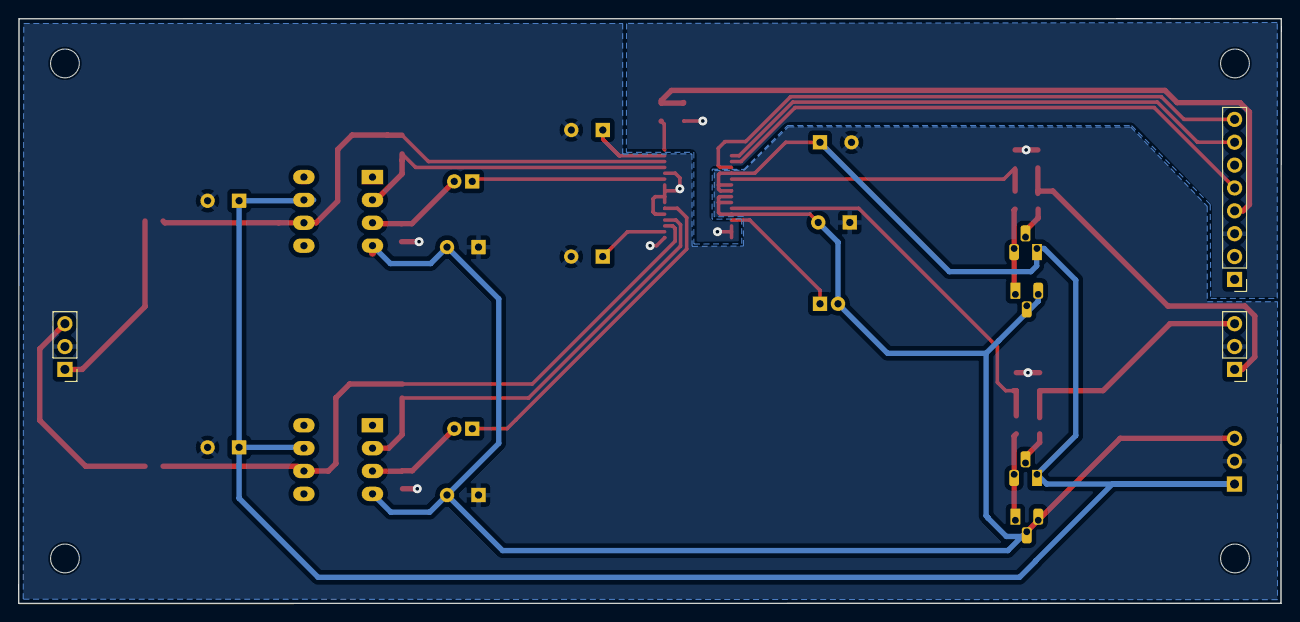
[picture p27: board Daughter-Board-Muses-Op-Amp.kicad_pcb from below]

Board: 2 copper layers, 140.3 x 65.0 mm, 38 parts (3 on the bottom side), 30 nets.
