Gninnorg/ThePreamp/Hardware/Digital PSU - LAdapter/Digital PSU - LAdapter.kicad_pcb

## KiCad design Hardware/Digital PSU - LAdapter/Digital PSU - LAdapter.kicad_pcb (2024-05-19)

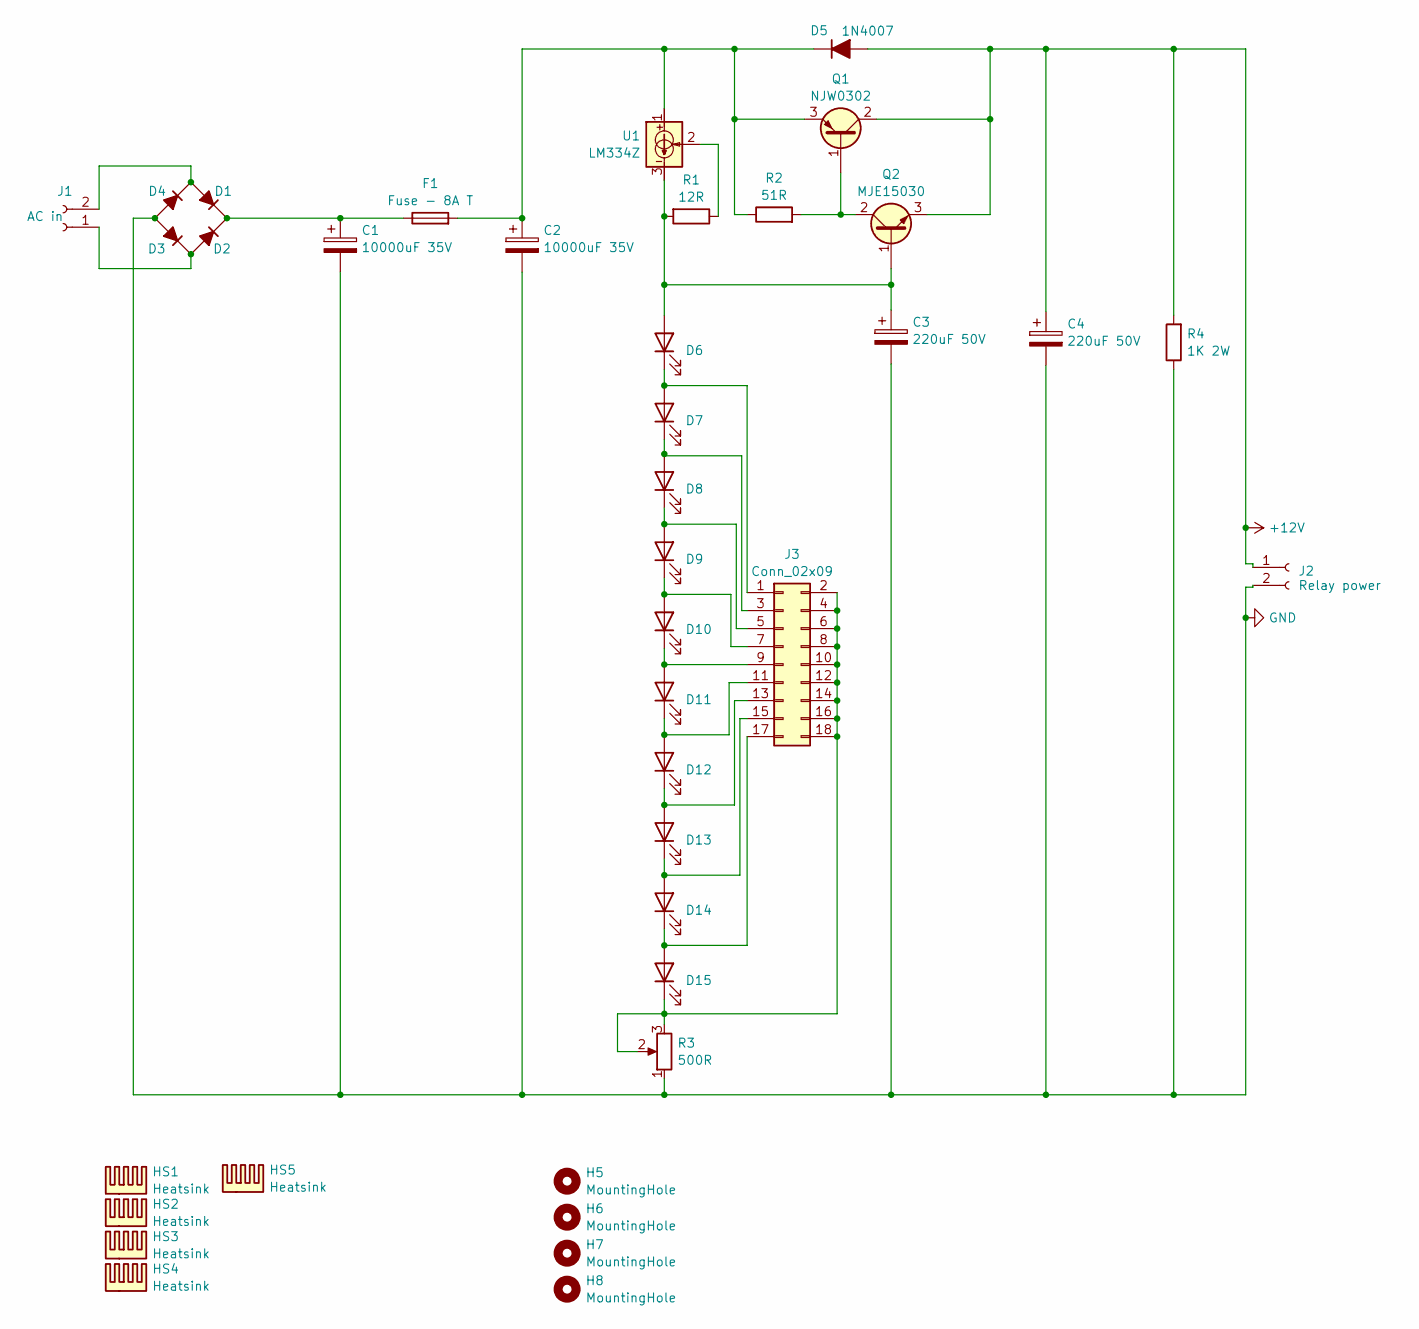
[picture p28: schematic Digital PSU - LAdapter.kicad_sch]

Parts:
C1, C2: 10000uF 35V; CP_Radial_D30.0mm_P10.00mm_SnapIn
C3, C4: 220uF 50V; CP_Radial_D10.0mm_P5.00mm
D1, D2, D3, D4: D_45deg_Filled; TO-220-2_Vertical
D5: 1N4007; D_DO-41_SOD81_P7.62mm_Horizontal
D6, D7, D8, D9, D10, D11, D12, D13, D14, D15: LED_Rectangular_W5.0mm_H2.0mm
F1: Fuse - 8A T; Keystone fuseholder 4527
H5, H6, H7, H8: MountingHole; MountingHole_3.2mm_M3_DIN965
HS1, HS2, HS3, HS4: Heatsink; Heatsink_Fischer_SK145-STS_29x12mm_2xDrill2.5mm
HS5: Heatsink; Heatsink_Fischer_SK129-STS_42x25mm_2xDrill2.5mm
J1: AC in; TBP01R1-508-02BK
J2: Relay power; TBP01R1-508-02BK
J3: Conn_02x09; PinHeader_2x09_P2.54mm_Vertical
Q1: NJW0302; TO-3P-3_Vertical_BCE
Q2: MJE15030; TO-220-3_Vertical_BCE
R1: 12R; R_Axial_DIN0207_L6.3mm_D2.5mm_P10.16mm_Horizontal
R2: 51R; R_Axial_DIN0207_L6.3mm_D2.5mm_P10.16mm_Horizontal
R3: 500R; Potentiometer_Bourns_3296W_Vertical
R4: 1K 2W; R_Axial_DIN0414_L11.9mm_D4.5mm_P15.24mm_Horizontal
U1: LM334Z; TO-92_Inline

Connections:
+12V: C4.1, D5.2 (A), J2.1, Q1.2 (C), Q2.3 (E), R4.2
GND: C1.2, C2.2, C3.2, C4.2, D3.2 (A), D4.2 (A), J2.2, R3.1, R4.1
unnamed: D1.2 (A), D4.1 (K), J1.2
unnamed: C1.1, D1.1 (K), D2.1 (K), F1.1
unnamed: D2.2 (A), D3.1 (K), J1.1
unnamed: C2.1, D5.1 (K), F1.2, Q1.3 (E), R2.1, U1.1
unnamed: C3.1, D6.2 (A), Q2.1 (B), R1.2, U1.3
unnamed: D6.1 (K), D7.2 (A), J3.1
unnamed: D7.1 (K), D8.2 (A), J3.3
unnamed: D8.1 (K), D9.2 (A), J3.5
unnamed: D9.1 (K), D10.2 (A), J3.7
unnamed: D10.1 (K), D11.2 (A), J3.9
unnamed: D11.1 (K), D12.2 (A), J3.11
unnamed: D12.1 (K), D13.2 (A), J3.13
unnamed: D13.1 (K), D14.2 (A), J3.15
unnamed: D14.1 (K), D15.2 (A), J3.17
unnamed: D15.1 (K), J3.2, J3.4, J3.6, J3.8, J3.10, J3.12, J3.14, J3.16, J3.18, R3.2, R3.3
unnamed: Q1.1 (B), Q2.2 (C), R2.2
unnamed: R1.1, U1.2

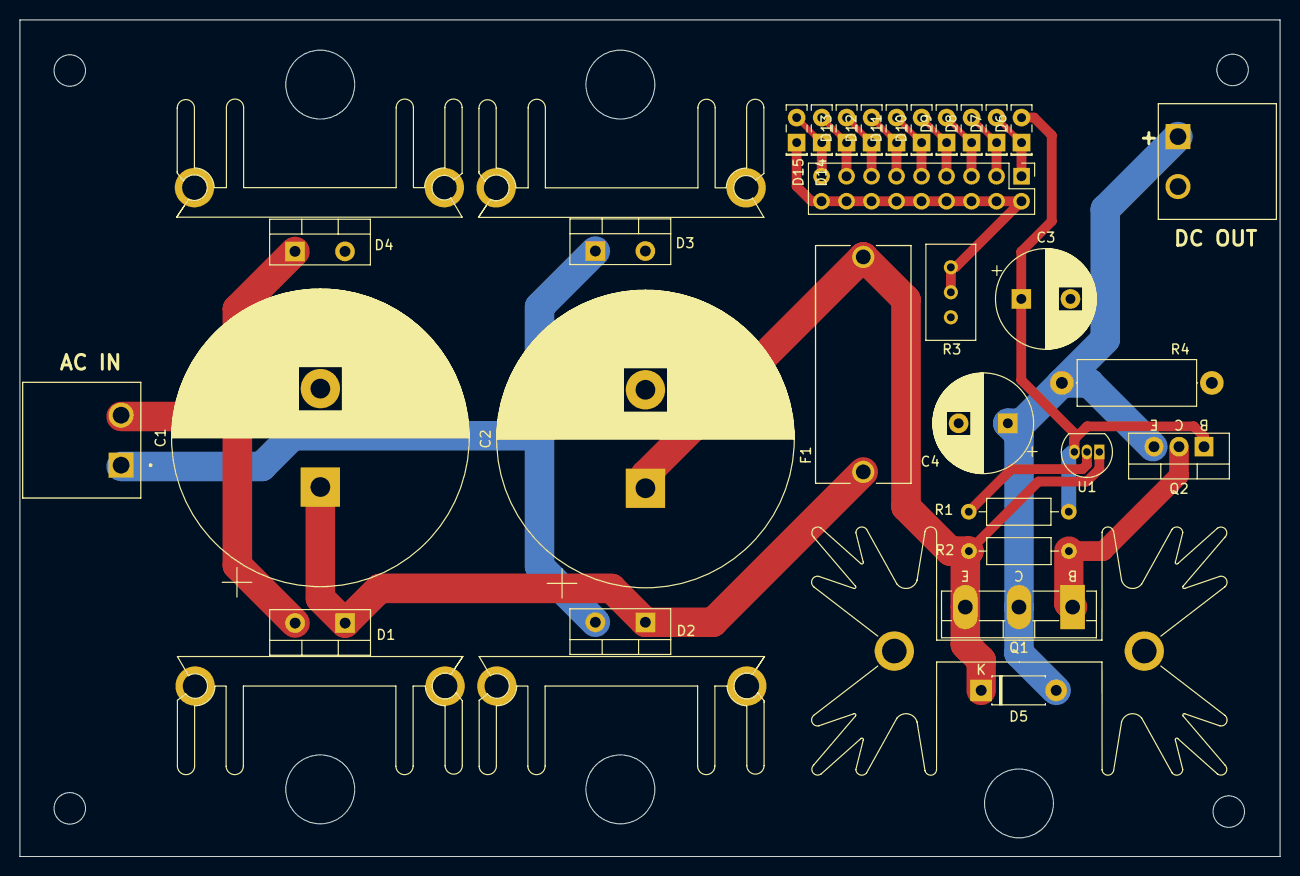
[picture p29: board Digital PSU - LAdapter.kicad_pcb from above]

Board: 2 copper layers, 128.0 x 85.0 mm, 39 parts (0 on the bottom side), 19 nets.
