Gninnorg/ThePreamp/Hardware/Digital PSU - 8V_3.3V/Digital PSU - 8V_3.3V.kicad_pcb

## KiCad design Hardware/Digital PSU - 8V_3.3V/Digital PSU - 8V_3.3V.kicad_pcb (2024-05-19)

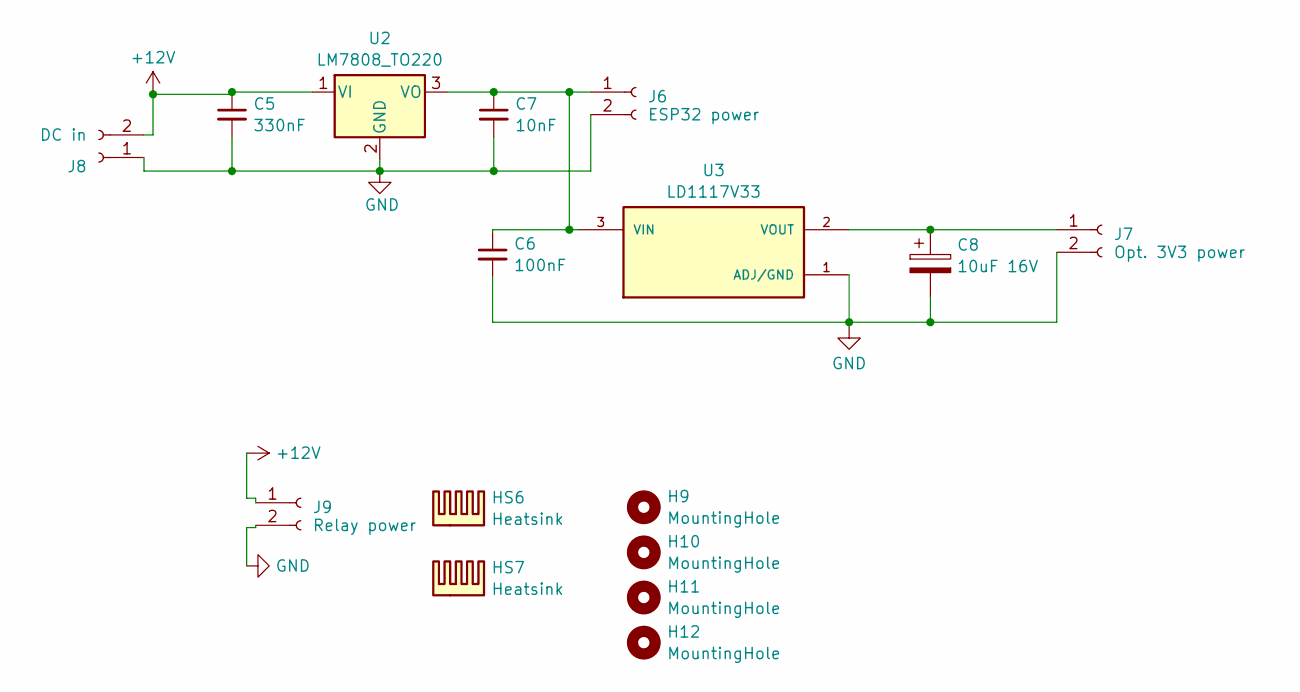
[picture p30: schematic Digital PSU - 8V_3.3V.kicad_sch]

Parts:
C5: 330nF; C_0805_2012Metric_Pad1.18x1.45mm_HandSolder
C6: 100nF; C_0805_2012Metric_Pad1.18x1.45mm_HandSolder
C7: 10nF; C_0805_2012Metric_Pad1.18x1.45mm_HandSolder
C8: 10uF 16V; C_1206_3216Metric_Pad1.33x1.80mm_HandSolder
H9, H10, H11, H12: MountingHole; MountingHole_3.2mm_M3_DIN965
HS6, HS7: Heatsink; Heatsink_Fischer_SK145-STS_29x12mm_2xDrill2.5mm
J6: ESP32 power; TBP01R1-508-02BK
J7: Opt. 3V3 power; TBP01R1-508-02BK
J8: DC in; TBP01R1-508-02BK
J9: Relay power; TBP01R1-508-02BK
U2: LM7808_TO220; TO-220-3_Vertical
U3: LD1117V33; TO-220-3_Vertical; PARTREV 37

Connections:
+12V: C5.1, J8.2, J9.1, U2.1 (VI)
GND: C5.2, C6.2, C7.2, C8.2, J6.2, J7.2, J8.1, J9.2, U2.2 (GND), U3.1 (ADJ/GND)
unnamed: C6.1, C7.1, J6.1, U2.3 (VO), U3.3 (VIN)
unnamed: C8.1, J7.1, U3.2 (VOUT)
