Gninnorg/ThePreamp/Hardware/Digital PSU - 8V_3.3V/Digital PSU - 8V_3.3V.kicad_pcb

## KiCad design Hardware/Digital PSU - 8V_3.3V/Digital PSU - 8V_3.3V.kicad_pcb (continued)

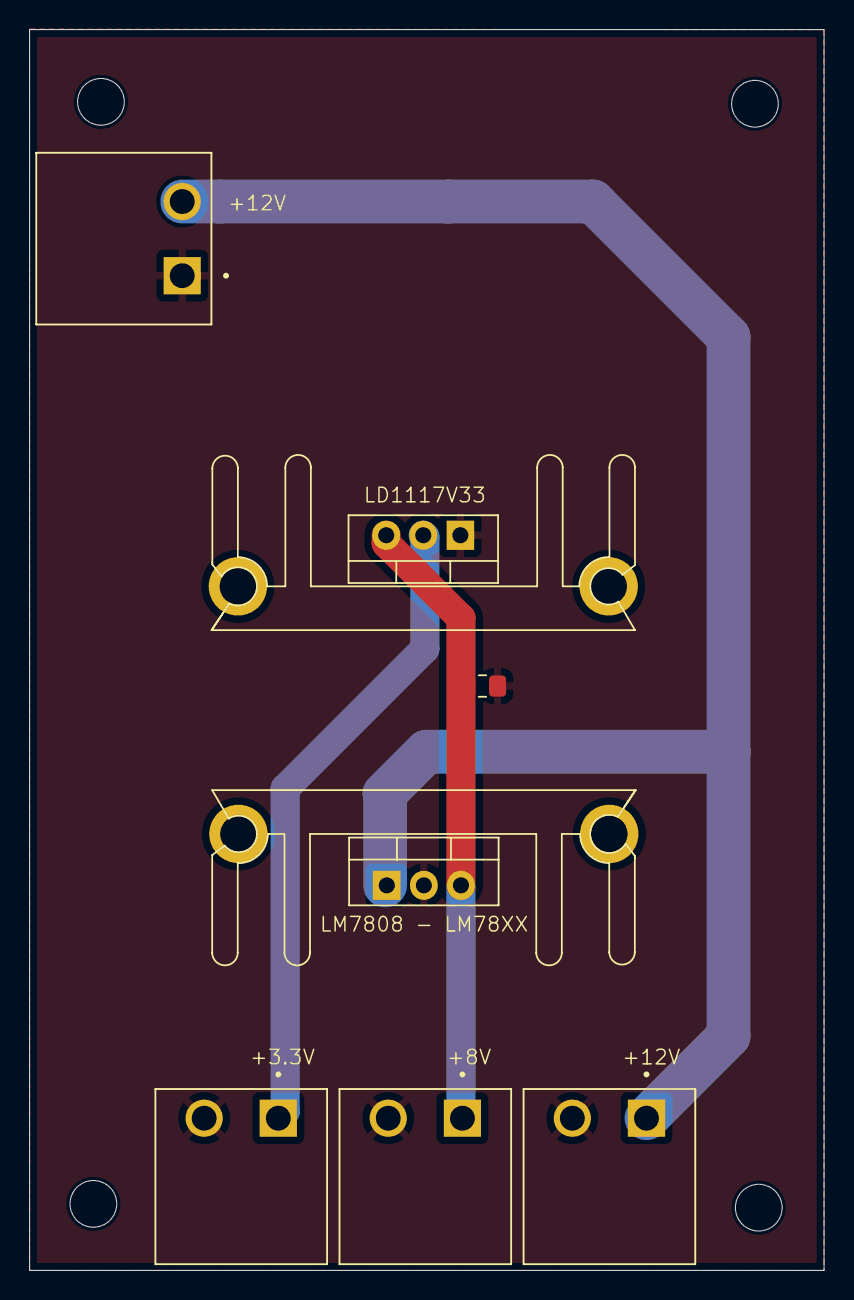
[picture p31: board Digital PSU - 8V_3.3V.kicad_pcb from above]

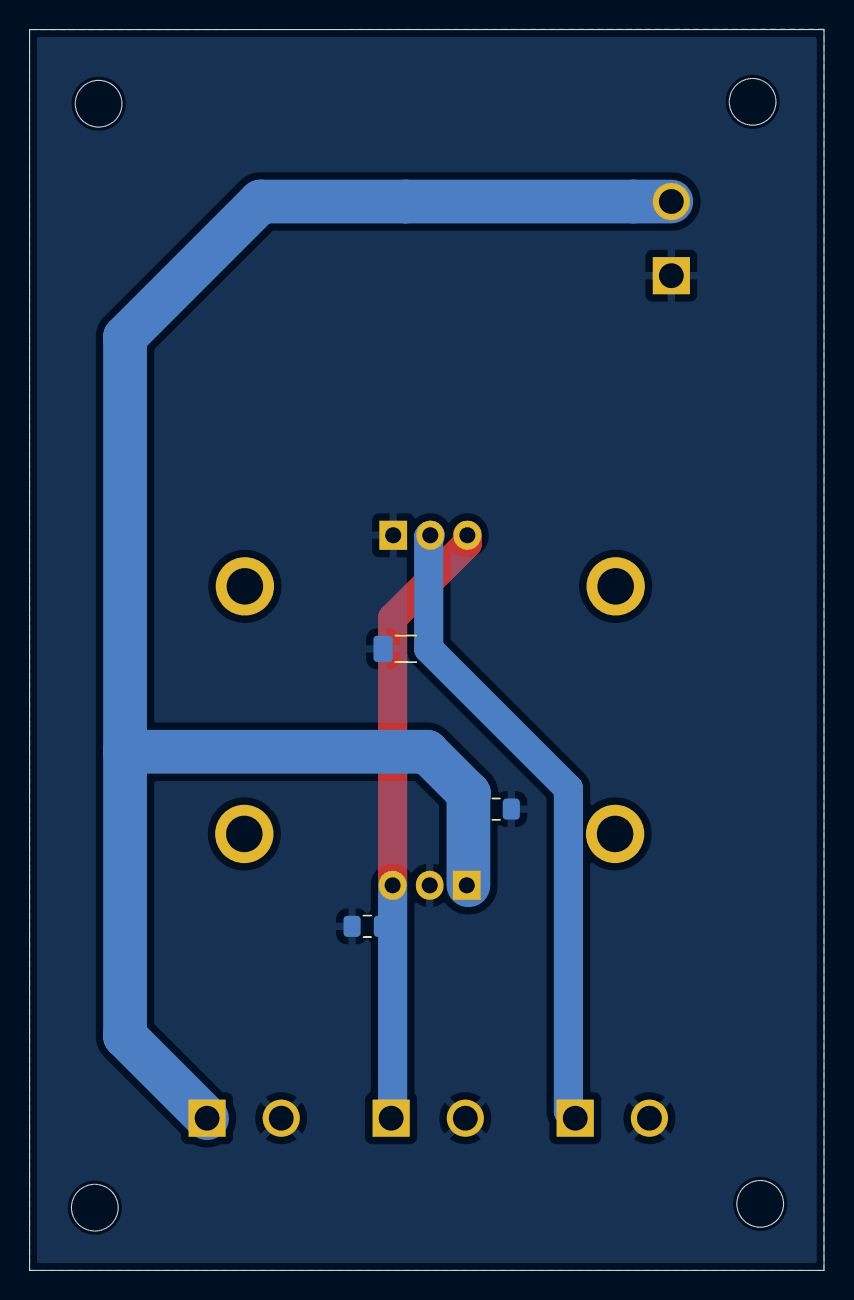
[picture p32: board Digital PSU - 8V_3.3V.kicad_pcb from below]

Board: 2 copper layers, 54.4 x 85.0 mm, 16 parts (3 on the bottom side), 4 nets.
