Gninnorg/ThePreamp/Hardware/Digital PSU - Transformer/Digital PSU - Transformer.kicad_pcb

## KiCad design Hardware/Digital PSU - Transformer/Digital PSU - Transformer.kicad_pcb (2024-05-19)

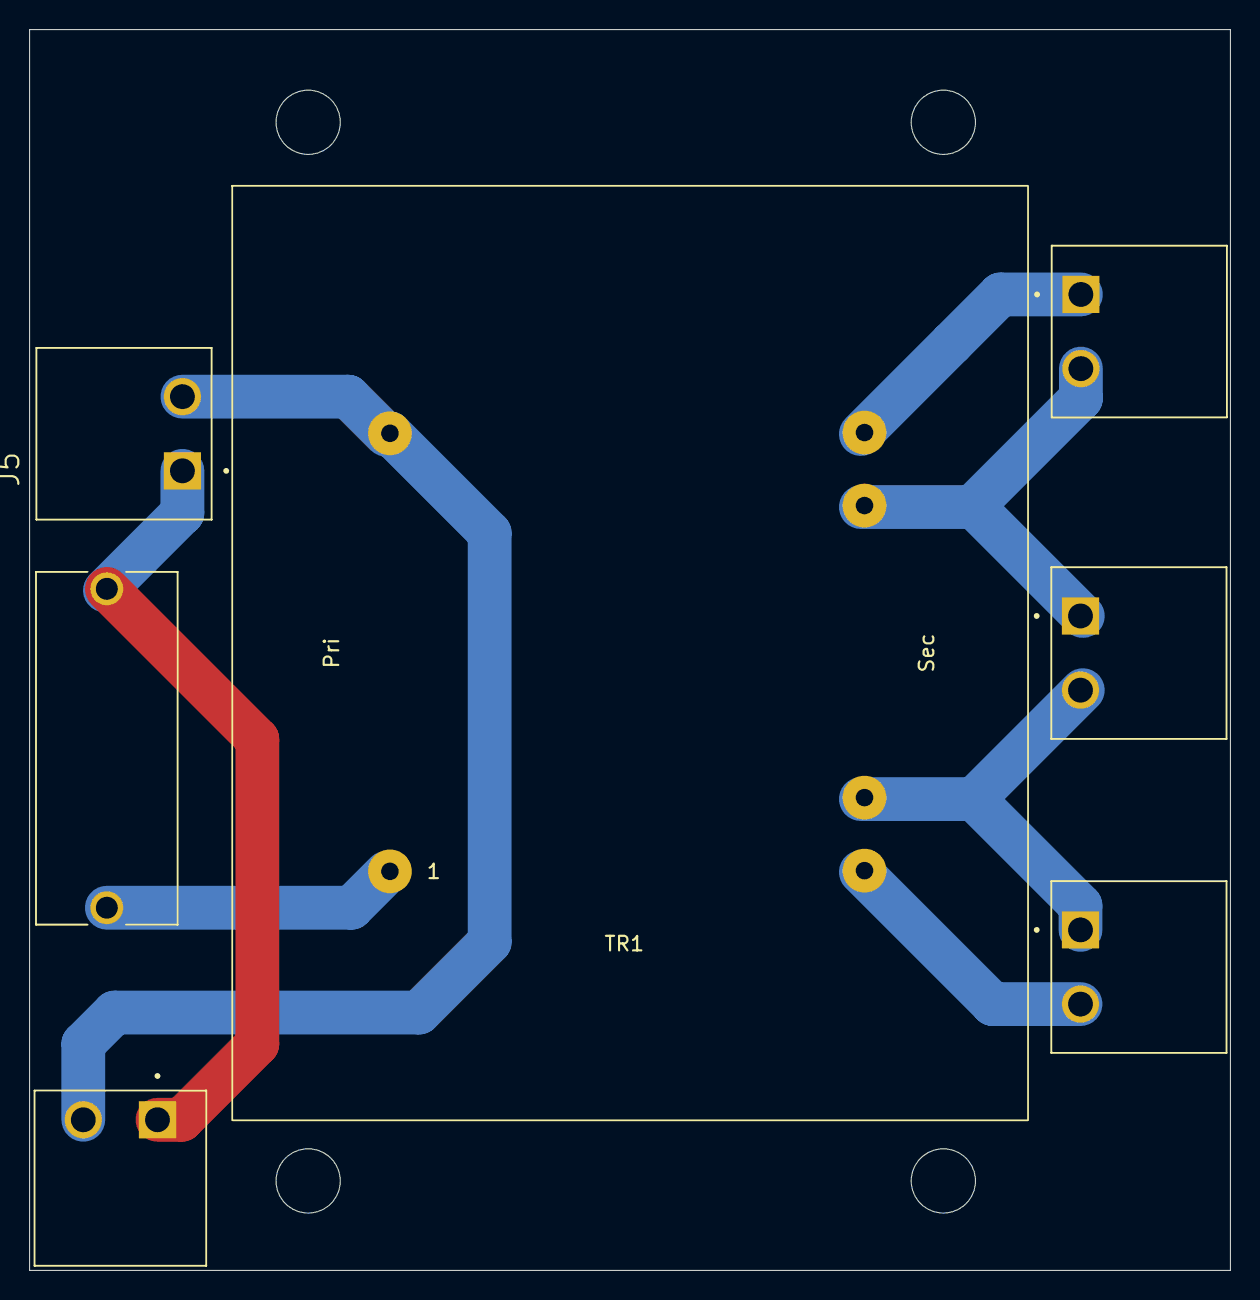
[picture p33: board Digital PSU - Transformer.kicad_pcb from above]

Board: 2 copper layers, 82.2 x 85.0 mm, 7 parts (0 on the bottom side), 7 nets.

Parts:
F2: Fuse - 8A T; Keystone fuseholder 4527
J1, J5: 230V AC; TBP01R1-508-02BK
J4: 15V AC; TBP01R1-508-02BK
J10, J11: 18V AC; TBP01R1-508-02BK
TR1: Hahn BV EL 603 1027; Transformer_Hahn_BV_EL_603_COMBINED

Connections:
unnamed: F2.2, TR1.1
unnamed: F2.1, J1.1, J5.1
unnamed: J1.2, J5.2, TR1.7
unnamed: J10.1, TR1.8
unnamed: J4.1, J10.2, TR1.9
unnamed: J4.2, J11.1, TR1.13
unnamed: J11.2, TR1.14
