Gninnorg/ThePreamp/Hardware/Analogue/Volume/Volume.kicad_pcb

## KiCad design Hardware/Analogue/Volume/Volume.kicad_pcb (2024-01-17)

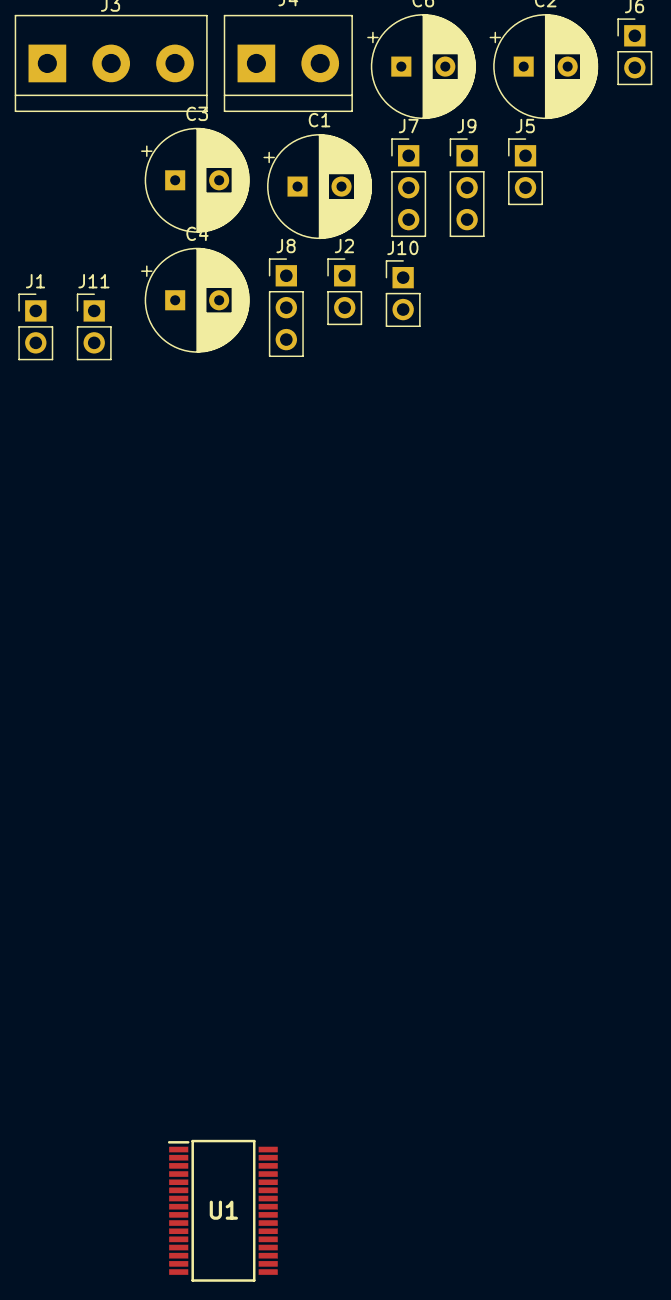
[picture p34: board Volume.kicad_pcb from above]

Board: 2 copper layers, 17 parts (0 on the bottom side), 14 nets, no tracks yet.

Parts:
C1, C2, C4, C6: 100 uf/25V; CP_Radial_D8.0mm_P3.50mm
C3: 10 uf/50V; CP_Radial_D8.0mm_P3.50mm
J1, J6: Audio In Right; PinHeader_1x02_P2.54mm_Vertical
J2, J5: Audio In Left; PinHeader_1x02_P2.54mm_Vertical
J3: Audio Power; TerminalBlock_bornier-3_P5.08mm
J4: Digital Power; TerminalBlock_bornier-2_P5.08mm
J7: Buffer Power; PinHeader_1x03_P2.54mm_Vertical
J8: Buffer In Left; PinHeader_1x03_P2.54mm_Vertical
J9: Buffer In Right; PinHeader_1x03_P2.54mm_Vertical
J10: Buffer Out Right; PinHeader_1x02_P2.54mm_Vertical
J11: Buffer Out Left; PinHeader_1x02_P2.54mm_Vertical
U1: Muses_72323; SOP65P760X145-32N

Connections:
+15V: C1.1, J3.1, J7.1, U1.21 (D_V+), U1.23 (AR_V+), U1.24 (AL_V+)
-15V: C2.2, J3.3, J7.3, U1.25 (AR_V-), U1.26 (AL_V-), U1.28 (D_V-)
Audio L buffer: J2.1, U1.27 (INL)
Audio R buffer: J1.1, U1.22 (INR)
GND: C1.2, C2.1, C3.2, C4.2, C6.2, J1.2, J2.2, J3.2, J4.2, J5.2, J6.2, J7.2, J10.2, J11.2, U1.1 (NC), U1.5 (L_REF), U1.7 (L_REF), U1.8 (L_REF), U1.9 (R_REF), U1.10 (R_REF), U1.12 (R_REF), U1.30 (ADR0), U1.31 (ADR1), U1.32 (D_REF)
L+: J8.3, U1.6 (L+)
L-: J8.2, U1.4 (L-)
unnamed: C3.1, U1.29 (D_CAP)
unnamed: C4.1, U1.2 (L_CAP)
unnamed: C6.1, U1.15 (R_CAP)
OUTL: J8.1, U1.3 (OUTL)
OUTR: J9.1, U1.14 (OUTR)
R+: J9.3, U1.11 (R+)
R-: J9.2, U1.13 (R-)
