Gninnorg/ThePreamp/Hardware/Analogue/Buffer-Opamp/Buffer-Opamp.kicad_pcb

## KiCad design Hardware/Analogue/Buffer-Opamp/Buffer-Opamp.kicad_pcb (2023-11-22)

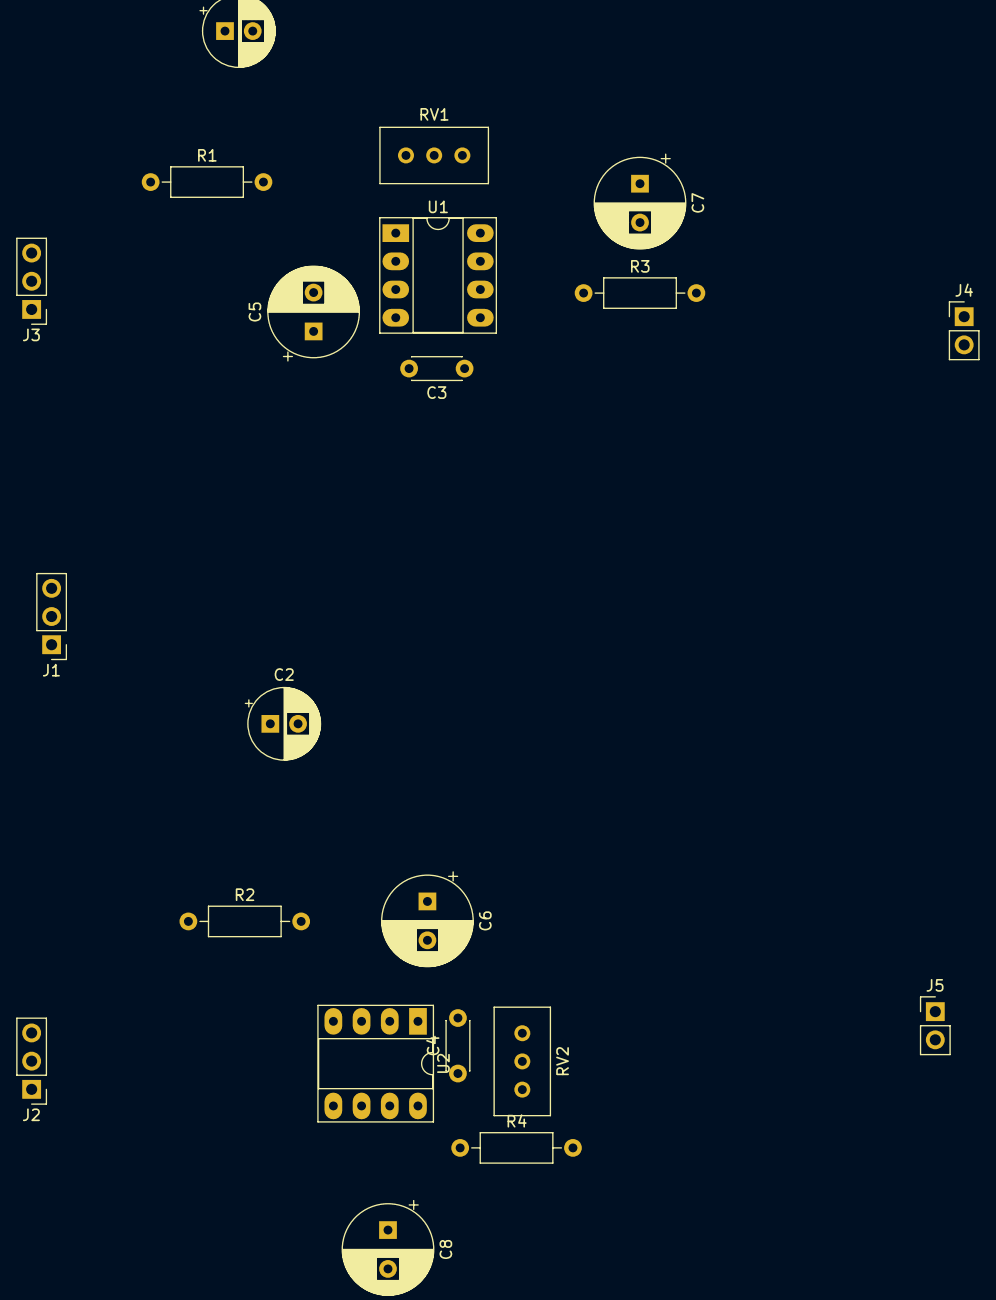
[picture p35: board Buffer-Opamp.kicad_pcb from above]

Board: 2 copper layers, 21 parts (0 on the bottom side), 17 nets, no tracks yet.

Parts:
C1, C2: 10 uF; CP_Radial_D6.3mm_P2.50mm
C3, C4: 10 pF; C_Disc_D4.3mm_W1.9mm_P5.00mm
C5, C6, C7, C8: 100 uf/25V; CP_Radial_D8.0mm_P3.50mm
J1, J2, J3: Conn_01x03_Female; PinHeader_1x03_P2.54mm_Vertical
J4, J5: Conn_01x02_Female; PinHeader_1x02_P2.54mm_Vertical
R1, R2: 100K; R_Axial_DIN0207_L6.3mm_D2.5mm_P10.16mm_Horizontal
R3, R4: 47; R_Axial_DIN0207_L6.3mm_D2.5mm_P10.16mm_Horizontal
RV1, RV2: 100k; Potentiometer_Bourns_3296W_Vertical
U1, U2: NE5534; DIP-8_W7.62mm_Socket_LongPads

Connections:
+15V: C7.1, C8.1, J1.1, RV1.2, RV2.2, U1.7 (V+), U2.7 (V+)
-15V: C5.2, C6.2, J1.3, U1.4 (V-), U2.4 (V-)
GND: C5.1, C6.1, C7.2, C8.2, J1.2, J4.2, J5.2, R1.1, R2.1
L+: C2.1, J2.3
L-: C4.2, J2.2, U2.2 (-)
unnamed: C1.2, R1.2, U1.3 (+)
unnamed: C2.2, R2.2, U2.3 (+)
unnamed: J4.1, R3.2
unnamed: J5.1, R4.2
unnamed: RV1.1, U1.8 (C/B)
unnamed: RV1.3, U1.1 (BAL)
unnamed: RV2.1, U2.8 (C/B)
unnamed: RV2.3, U2.1 (BAL)
OUTL: C4.1, J2.1, R4.1, U2.6
OUTR: C3.1, J3.1, R3.1, U1.6
R+: C1.1, J3.3
R-: C3.2, J3.2, U1.2 (-)
