Gninnorg/ThePreamp/Software/ThePreamp Controller/src/input_controller.cpp

#include "input_controller.h"
#include "audio_controller.h"
#include "display_controller.h"
#include "trigger_controller.h"

#define ROTARY_ENCODER_STEPS 4
#define ROTARY1_CW_PIN 25
#define ROTARY1_CCW_PIN 26
#define ROTARY1_SW_PIN 34
#define ROTARY2_CW_PIN 27
#define ROTARY2_CCW_PIN 14
#define ROTARY2_SW_PIN 35

ClickEncoder *encoder1 = new ClickEncoder(ROTARY1_CW_PIN, ROTARY1_CCW_PIN, ROTARY1_SW_PIN, ROTARY_ENCODER_STEPS, LOW);
ClickEncoder::Button button1;
int16_t e1last, e1value;

ClickEncoder *encoder2 = new ClickEncoder(ROTARY2_CW_PIN, ROTARY2_CCW_PIN, ROTARY2_SW_PIN, ROTARY_ENCODER_STEPS, LOW);
ClickEncoder::Button button2;
int16_t e2last, e2value;

volatile int interruptCounter;
int totalInterruptCounter;

hw_timer_t *timer = NULL;
portMUX_TYPE timerMux = portMUX_INITIALIZER_UNLOCKED;

volatile bool irLearnActive = false;
volatile bool irLearnCodeReady = false;
volatile uint64_t irLearnCode = 0;

extern Muses72323 muses;
extern Adafruit_MCP23008 relayController;
extern byte appMode;
extern unsigned long mil_LastUserInput;
extern unsigned long last_KEY_ONOFF;
extern const long interval;

void IRAM_ATTR timerIsr()
{
  encoder1->service();
  encoder2->service();
  portENTER_CRITICAL_ISR(&timerMux);
  interruptCounter++;
  portEXIT_CRITICAL_ISR(&timerMux);
}

void startIrLearning()
{
  irLearnCodeReady = false;
  irLearnCode = 0;
  irLearnActive = true;
}

void setupRotaryEncoders()
{
  pinMode(ROTARY1_CW_PIN, INPUT_PULLUP);
  pinMode(ROTARY1_CCW_PIN, INPUT_PULLUP);
  pinMode(ROTARY1_SW_PIN, INPUT);
  pinMode(ROTARY2_CW_PIN, INPUT_PULLUP);
  pinMode(ROTARY2_CCW_PIN, INPUT_PULLUP);
  pinMode(ROTARY2_SW_PIN, INPUT);
  timer = timerBegin(0, 80, true);
  timerAttachInterrupt(timer, &timerIsr, true);
  timerAlarmWrite(timer, 1000, true);
  timerAlarmEnable(timer);
}

byte getUserCommand()
{
  if (interruptCounter > 0)
  {
    portENTER_CRITICAL(&timerMux);
    interruptCounter--;
    portEXIT_CRITICAL(&timerMux);
    totalInterruptCounter++;
  }

  byte receivedInput = KEY_NONE;

  e1value += encoder1->getValue();
  if (e1value != e1last)
  {
    if (e1value > e1last)
      receivedInput = KEY_UP;
    if (e1value < e1last)
      receivedInput = KEY_DOWN;
    e1last = e1value;
  }

  button1 = encoder1->getButton();
  switch (button1)
  {
  case ClickEncoder::Clicked:
    receivedInput = KEY_SELECT;
    break;
  default:
    break;
  }

  e2value += encoder2->getValue();
  if (e2value != e2last)
  {
    if (e2value > e2last)
      receivedInput = KEY_RIGHT;
    if (e2value < e2last)
      receivedInput = KEY_LEFT;
    e2last = e2value;
  }

  button2 = encoder2->getButton();
  switch (button2)
  {
  case ClickEncoder::Clicked:
    receivedInput = KEY_INFO;
    break;
  case ClickEncoder::DoubleClicked:
    if (appMode == APP_STANDBY_MODE)
      receivedInput = KEY_ON;
    else
      receivedInput = KEY_OFF;
    break;
  default:
    break;
  }

  if (irrecv.decode(&IRresults))
  {
    if (irLearnActive)
    {
      irLearnCode = IRresults.value;
      irLearnCodeReady = true;
      irLearnActive = false;
    }
    else if (IRresults.value == Settings.IR_UP)
      receivedInput = KEY_UP;
    else if (IRresults.value == Settings.IR_DOWN)
      receivedInput = KEY_DOWN;
    else if (IRresults.value == Settings.IR_LEFT)
      receivedInput = KEY_LEFT;
    else if (IRresults.value == Settings.IR_RIGHT)
      receivedInput = KEY_RIGHT;
    else if (IRresults.value == Settings.IR_SELECT)
      receivedInput = KEY_SELECT;
    else if (IRresults.value == Settings.IR_INFO)
      receivedInput = KEY_INFO;
    else if (IRresults.value == Settings.IR_MUTE)
      receivedInput = KEY_MUTE;
    else if (appMode == APP_STANDBY_MODE && IRresults.value == Settings.IR_ON)
      receivedInput = KEY_ON;
    else if (appMode == APP_NORMAL_MODE && IRresults.value == Settings.IR_OFF)
      receivedInput = KEY_OFF;
    else if (IRresults.value == Settings.IR_1)
      receivedInput = KEY_1;
    else if (IRresults.value == Settings.IR_2)
      receivedInput = KEY_2;
    else if (IRresults.value == Settings.IR_3)
      receivedInput = KEY_3;
    else if (IRresults.value == Settings.IR_4)
      receivedInput = KEY_4;
    else if (IRresults.value == Settings.IR_5)
      receivedInput = KEY_5;
    else if (IRresults.value == Settings.IR_POWER)
      receivedInput = appMode == APP_STANDBY_MODE ? KEY_ON : KEY_OFF;
    else if (IRresults.value == Settings.IR_REPEAT)
    {
      receivedInput = KEY_REPEAT;
      if (lastReceivedInput == KEY_UP)
        receivedInput = KEY_UP;
      else if (lastReceivedInput == KEY_DOWN)
        receivedInput = KEY_DOWN;
    }
    lastReceivedInput = receivedInput;
    irrecv.resume();
  }

  if (receivedInput != KEY_NONE)
  {
    mil_LastUserInput = millis();
  }

  return receivedInput;
}

void toAppNormalMode()
{
  appMode = APP_NORMAL_MODE;
  left_display_update();
  right_display_update();
}

void toStandbyMode()
{
  appMode = APP_STANDBY_MODE;
  writeRuntimeSettingsToEEPROM();
  mute();
  muteOutput();
  left_display.clearDisplay();
  right_display.clearDisplay();
  setTrigger1Off();
  setTrigger2Off();
  if (Settings.ExtPowerRelayTrigger)
  {
    digitalWrite(POWER_CONTROL_PIN, LOW);
  }
  last_KEY_ONOFF = millis();
}

boolean setInput(uint8_t NewInput)
{
  boolean result = false;
  if (NewInput > 4 || appMode != APP_NORMAL_MODE || Settings.Input[NewInput].Active == INPUT_INACTIVATED)
    return result;

  if (NewInput == RuntimeSettings.CurrentInput)
    return true;

  {
    if (!RuntimeSettings.Muted)
      mute();

    relayController.digitalWrite(7 - RuntimeSettings.CurrentInput, LOW);
    RuntimeSettings.PrevSelectedInput = RuntimeSettings.CurrentInput;
    muses.setGain(Settings.Input[RuntimeSettings.CurrentInput].Gain);
    RuntimeSettings.CurrentInput = NewInput;

    if (Settings.RecallSetLevel)
      RuntimeSettings.CurrentVolume = RuntimeSettings.InputLastVol[RuntimeSettings.CurrentInput];
    else if (RuntimeSettings.CurrentVolume > Settings.Input[RuntimeSettings.CurrentInput].MaxVol)
      RuntimeSettings.CurrentVolume = Settings.Input[RuntimeSettings.CurrentInput].MaxVol;
    else if (RuntimeSettings.CurrentVolume < Settings.Input[RuntimeSettings.CurrentInput].MinVol)
      RuntimeSettings.CurrentVolume = Settings.Input[RuntimeSettings.CurrentInput].MinVol;

    relayController.digitalWrite(7 - NewInput, HIGH);

    if (RuntimeSettings.Muted)
      unmute();
    else
      setVolume(RuntimeSettings.CurrentVolume);

    left_display_update();
    result = true;
  }
  return result;
}

void setPrevInput(void)
{
  byte nextInput = (RuntimeSettings.CurrentInput == 0) ? 4 : RuntimeSettings.CurrentInput - 1;
  while (Settings.Input[nextInput].Active == INPUT_INACTIVATED)
  {
    nextInput = (nextInput == 0) ? 5 : nextInput - 1;
  }
  setInput(nextInput);
}

void setNextInput(void)
{
  byte nextInput = (RuntimeSettings.CurrentInput == 4) ? 0 : RuntimeSettings.CurrentInput + 1;
  while (Settings.Input[nextInput].Active == INPUT_INACTIVATED)
  {
    nextInput = (nextInput == 4) ? 0 : nextInput + 1;
  }
  setInput(nextInput);
}

// Value being adjusted while APP_BALANCE_MODE is active - not committed until saveBalance() is called
static byte BalanceEditValue;

bool changeBalance()
{
  appMode = APP_BALANCE_MODE;
  BalanceEditValue = constrain((int)RuntimeSettings.InputLastBal[RuntimeSettings.CurrentInput], BALANCE_CENTER - BALANCE_MAX_OFFSET, BALANCE_CENTER + BALANCE_MAX_OFFSET);
  left_display_update();
  displayBalance(BalanceEditValue);
  return true;
}

void adjustBalance(int8_t delta)
{
  int newValue = constrain((int)BalanceEditValue + delta, BALANCE_CENTER - BALANCE_MAX_OFFSET, BALANCE_CENTER + BALANCE_MAX_OFFSET);
  BalanceEditValue = (byte)newValue;
  applyBalance(BalanceEditValue);
  displayBalance(BalanceEditValue);
}

void saveBalance()
{
  RuntimeSettings.InputLastBal[RuntimeSettings.CurrentInput] = BalanceEditValue;
  writeRuntimeSettingsToEEPROM();
  toAppNormalMode();
}

static byte infoPage = 0;

void showInfoScreen()
{
  appMode = APP_INFO_MODE;
  infoPage = 0;
  displayInfoScreen(infoPage);
}

void changeInfoPage(int direction)
{
  infoPage = (infoPage + INFO_PAGE_COUNT + direction) % INFO_PAGE_COUNT;
  displayInfoScreen(infoPage);
}
