Gninnorg/ThePreamp/Software/ThePreamp Controller/src/wifi_QR.h

#ifndef WIFI_QR_H
#define WIFI_QR_H

// 'ThePreAmp wifi QR', 64x64px
const uint8_t ThePreAmp_wifi_QR [] = {
	0x00, 0x80, 0x0f, 0xfc, 0xc1, 0xc3, 0x01, 0x00, 0x00, 0x80, 0x0f, 0xfc, 0xc1, 0xc3, 0x01, 0x00, 
	0xfc, 0x9f, 0xff, 0xff, 0x3f, 0xf3, 0xf9, 0x3f, 0xfc, 0x9f, 0xff, 0xff, 0x3f, 0xf3, 0xf9, 0x3f, 
	0x0c, 0x98, 0x03, 0x7f, 0xc6, 0xc3, 0x19, 0x30, 0x0c, 0x98, 0x03, 0x7f, 0xc6, 0xc3, 0x19, 0x30, 
	0x0c, 0x98, 0x03, 0x7f, 0xc6, 0xc3, 0x19, 0x30, 0x0c, 0x98, 0x03, 0xe3, 0xc7, 0xfc, 0x19, 0x30, 
	0x0c, 0x98, 0x03, 0xe3, 0xc7, 0xfc, 0x19, 0x30, 0x0c, 0x98, 0xf3, 0x00, 0xf8, 0xc0, 0x19, 0x30, 
	0x0c, 0x98, 0xf3, 0x00, 0xf8, 0xc0, 0x19, 0x30, 0xfc, 0x9f, 0x03, 0x00, 0x00, 0xf3, 0xf9, 0x3f, 
	0xfc, 0x9f, 0x03, 0x00, 0x00, 0xf3, 0xf9, 0x3f, 0x00, 0x80, 0x33, 0x63, 0xc6, 0xcc, 0x01, 0x00, 
	0x00, 0x80, 0x33, 0x63, 0xc6, 0xcc, 0x01, 0x00, 0x00, 0x80, 0x03, 0x00, 0xc0, 0xc0, 0x01, 0x00, 
	0xff, 0xff, 0xc3, 0x80, 0xf9, 0xc0, 0xff, 0xff, 0xff, 0xff, 0xc3, 0x80, 0xf9, 0xc0, 0xff, 0xff, 
	0x0c, 0x80, 0x3f, 0x63, 0xf8, 0xfc, 0x01, 0xf0, 0x0c, 0x80, 0x3f, 0x63, 0xf8, 0xfc, 0x01, 0xf0, 
	0xf3, 0xe1, 0x33, 0xff, 0xc1, 0x33, 0x1e, 0xfe, 0xf3, 0xe1, 0x33, 0xff, 0xc1, 0x33, 0x1e, 0xfe, 
	0xfc, 0x07, 0xf0, 0xff, 0x3f, 0xc3, 0x87, 0x0f, 0xfc, 0x07, 0xf0, 0xff, 0x3f, 0xc3, 0x87, 0x0f, 
	0xf3, 0xe7, 0x03, 0x7f, 0xc6, 0xf3, 0x01, 0xce, 0xf3, 0xe7, 0x03, 0x7f, 0xc6, 0xf3, 0x01, 0xce, 
	0xf3, 0xe7, 0x03, 0x7f, 0xc6, 0xf3, 0x01, 0xce, 0x80, 0x01, 0x0c, 0xe0, 0x07, 0x3c, 0x86, 0xf1, 
	0x80, 0x01, 0x0c, 0xe0, 0x07, 0x3c, 0x86, 0xf1, 0x7f, 0xfe, 0x0f, 0x03, 0xf8, 0x0f, 0x00, 0x3e, 
	0x7f, 0xfe, 0x0f, 0x03, 0xf8, 0x0f, 0x00, 0x3e, 0xff, 0x1f, 0xc0, 0x1f, 0x00, 0xcf, 0xff, 0xff, 
	0xff, 0x1f, 0xc0, 0x1f, 0x00, 0xcf, 0xff, 0xff, 0x80, 0x79, 0x3c, 0x83, 0xf9, 0x0f, 0x80, 0xf1, 
	0x80, 0x79, 0x3c, 0x83, 0xf9, 0x0f, 0x80, 0xf1, 0x80, 0x79, 0x3c, 0x83, 0xf9, 0x0f, 0x80, 0xf1, 
	0x70, 0x80, 0xc3, 0x60, 0x38, 0xcc, 0x1f, 0xfe, 0x70, 0x80, 0xc3, 0x60, 0x38, 0xcc, 0x1f, 0xfe, 
	0x7c, 0x7e, 0x00, 0xe3, 0xc1, 0xf3, 0xff, 0x3f, 0x7c, 0x7e, 0x00, 0xe3, 0xc1, 0xf3, 0xff, 0x3f, 
	0x8c, 0x19, 0xcc, 0xfc, 0x3f, 0xc0, 0x7f, 0x00, 0x8c, 0x19, 0xcc, 0xfc, 0x3f, 0xc0, 0x7f, 0x00, 
	0x7c, 0x78, 0x3c, 0x63, 0x06, 0x33, 0x86, 0xf1, 0x7c, 0x78, 0x3c, 0x63, 0x06, 0x33, 0x86, 0xf1, 
	0x7c, 0x78, 0x3c, 0x63, 0x06, 0x33, 0x86, 0xf1, 0x8c, 0x19, 0x3c, 0xff, 0x07, 0x0c, 0x80, 0xc1, 
	0x8c, 0x19, 0x3c, 0xff, 0x07, 0x0c, 0x80, 0xc1, 0xff, 0xff, 0xc3, 0x1c, 0xf8, 0xcf, 0x1f, 0xce, 
	0xff, 0xff, 0xc3, 0x1c, 0xf8, 0xcf, 0x1f, 0xce, 0x00, 0x80, 0xff, 0x1f, 0x00, 0xcc, 0x19, 0xfe, 
	0x00, 0x80, 0xff, 0x1f, 0x00, 0xcc, 0x19, 0xfe, 0xfc, 0x9f, 0xf3, 0x9f, 0x39, 0xcf, 0x9f, 0x0f, 
	0xfc, 0x9f, 0xf3, 0x9f, 0x39, 0xcf, 0x9f, 0x0f, 0x0c, 0x98, 0xc3, 0x63, 0x38, 0x0c, 0x00, 0x00, 
	0x0c, 0x98, 0xc3, 0x63, 0x38, 0x0c, 0x00, 0x00, 0x0c, 0x98, 0xc3, 0x63, 0x38, 0x0c, 0x00, 0x00, 
	0x0c, 0x98, 0xf3, 0xe0, 0xc1, 0x03, 0x9e, 0xff, 0x0c, 0x98, 0xf3, 0xe0, 0xc1, 0x03, 0x9e, 0xff, 
	0x0c, 0x98, 0xf3, 0x80, 0xff, 0xf0, 0x07, 0xc0, 0x0c, 0x98, 0xf3, 0x80, 0xff, 0xf0, 0x07, 0xc0, 
	0xfc, 0x9f, 0x3f, 0xff, 0xc7, 0xf0, 0x87, 0x31, 0xfc, 0x9f, 0x3f, 0xff, 0xc7, 0xf0, 0x87, 0x31, 
	0x00, 0x80, 0xf3, 0x7f, 0xfe, 0x00, 0x80, 0xf1, 0x00, 0x80, 0xf3, 0x7f, 0xfe, 0x00, 0x80, 0xf1
};

#endif // WIFI_QR_H
