Gninnorg/ThePreamp/(commit log)

2023-05-10 Initial pcb design
    [ThePreamp.csv, ThePreamp.kicad_pcb, ThePreamp.kicad_sch, ThePreamp.sch]
2023-05-10 Clean up directories
    [ThePreamp.csv, ThePreamp.kicad_pcb, ThePreamp.kicad_sch, ThePreamp.sch]
2023-05-10 schematic initial draft
    [ThePreamp-Analogue.csv, ThePreamp-Analogue.kicad_pcb, ThePreamp-Analogue.kicad_sch, ThePreamp-Analogue.sch, ThePreamp-Controller.csv, ThePreamp-Controller.kicad_pcb, ThePreamp-Controller.kicad_sch, ThePreamp-Controller.sch]
2023-08-12 added footprint to rca connector
    [ThePreamp-Analogue.kicad_pcb, ThePreamp-Analogue.kicad_sch]
2023-08-16 Added input section
    [ThePreamp-Analogue.kicad_pcb, ThePreamp-Analogue.kicad_sch]
2023-09-27 added muses72323
    [ThePreamp-Analogue.kicad_sch]
2023-10-11 ADD ANALOG PART
    [ThePreamp-Analogue.kicad_sch]
2023-10-26 seperate kicad project for buffer
    [Buffer-Opamp.kicad_pcb, Buffer-Opamp.kicad_sch, ThePreamp-Analogue.kicad_pcb, ThePreamp-Analogue.kicad_sch]
2023-11-22 analogue pcb work
    [Buffer-Opamp.kicad_pcb, Buffer-Opamp.kicad_sch, ThePreamp-Analogue.kicad_sch]
2023-11-29 update analogue schematic
    [ThePreamp-Analogue.kicad_pcb, ThePreamp-Analogue.kicad_sch]
2023-12-20 rca pcb layout v.0.8
    [ThePreamp-Analogue.kicad_pcb]
2024-01-17 more pcb layout
    [ThePreamp-Analogue.kicad_pcb, ThePreamp-Analogue.kicad_sch, Volume.kicad_pcb, Volume.kicad_sch]
2024-01-17 KiCad 7 and updated pcb
    [ThePreamp-Analogue.kicad_pcb, ThePreamp-Analogue.kicad_sch]
2024-01-24 pcb redesign
    [ThePreamp-Analogue-B_Cu.gbr, ThePreamp-Analogue-B_Mask.gbr, ThePreamp-Analogue-B_Paste.gbr, ThePreamp-Analogue-B_SilkS.gbr, ThePreamp-Analogue-Edge_Cuts.gbr, ThePreamp-Analogue-F_Cu.gbr, ThePreamp-Analogue-F_Mask.gbr, ThePreamp-Analogue-F_Paste.gbr]
2024-01-27 Added Trigger functionality (12V and switch)
    [ThePreamp-Analogue.kicad_pcb, ThePreamp-Analogue.kicad_sch]
2024-01-28 Added +12V to COM on ULN2803 (common fly back diode)
    [ThePreamp-Analogue.kicad_pcb, ThePreamp-Analogue.kicad_sch, bom.csv, designators.csv, positions.csv]
2024-01-31 Final version?
    [ThePreamp-Analogue-B_Cu.gbr, ThePreamp-Analogue-B_Mask.gbr, ThePreamp-Analogue-B_Paste.gbr, ThePreamp-Analogue-B_SilkS.gbr, ThePreamp-Analogue-Edge_Cuts.gbr, ThePreamp-Analogue-F_Cu.gbr, ThePreamp-Analogue-F_Mask.gbr, ThePreamp-Analogue-F_Paste.gbr]
2024-02-03 Added KiCad template for daughter board(s)
    [bom.csv, designators.csv, positions.csv]
2024-02-03 Added template for daughter board
    [Template-Daughter-board.kicad_pcb, Template-Daughter-board.kicad_sch, ThePreamp-Analogue.csv, ThePreamp-Analogue.sch]
2024-02-03 Controller pcb dimensions added
    [ThePreamp-Controller.kicad_pcb, ThePreamp-Controller.kicad_sch, ThePreamp-Controller.sch]
2024-02-04 Displays changed to SPI
    [ThePreamp-Controller.kicad_pcb, ThePreamp-Controller.kicad_sch]
2024-02-04 Test code for two displays
    [ThePreamp-Controller.kicad_sch]
2024-02-04 Pins updated
    [ThePreamp-Controller.kicad_pcb, ThePreamp-Controller.kicad_sch]
2024-02-04 Add power relay control output
    [ThePreamp-Controller.kicad_pcb, ThePreamp-Controller.kicad_sch]
2024-02-06 Added symbol/footprint for display
    [ThePreamp-Controller.kicad_pcb, ThePreamp-Controller.kicad_sch]
2024-02-11 Controller pcb is ready (except for connectors)
    [EEEFH1C471L.step, ThePreamp-Controller.kicad_pcb, ThePreamp-Controller.kicad_sch]
2024-02-12 Moved digital connector to match analog pcb
    [ThePreamp-Controller.kicad_pcb]
2024-02-14 Silk screens added
    [ThePreamp-Analogue.kicad_pcb]
2024-02-17 v1.1 - added internal input and IDC for switches etc
    [ThePreamp-Analogue.kicad_pcb, ThePreamp-Analogue.kicad_sch]
2024-02-18 Changed switch connector to 1 row
    [ThePreamp-Analogue.kicad_pcb, ThePreamp-Analogue.kicad_sch]
2024-02-18 Silkscreen updates
    [ThePreamp-Analogue.kicad_pcb]
2024-02-18 16 pin IDC connector added for digital control input (GND interleaved)
    [ThePreamp-Analogue.kicad_pcb, ThePreamp-Analogue.kicad_sch]
2024-02-25 Digital connector (IDC 16) aligned on controller and analog board
    [ThePreamp-Analogue.kicad_pcb, ThePreamp-Controller.kicad_pcb, ThePreamp-Controller.kicad_sch]
2024-02-26 Added optional M8 connectors for switches, 12V triggers and analog measurements
    [ThePreamp-Analogue.kicad_pcb, ThePreamp-Analogue.kicad_sch, bom.csv, designators.csv, positions.csv]
2024-02-27 Changed power connectors
    [CUI_DEVICES_TBP01R1-508-02BK.step, CUI_DEVICES_TBP01R1-508-03BK.step, CUI_DEVICES_TBP01R2-508-02BK.step, CUI_DEVICES_TBP01R2-508-03BK.step, ThePreamp-Analogue.kicad_pcb, ThePreamp-Analogue.kicad_sch, ThePreamp-Controller.kicad_pcb, ThePreamp-Controller.kicad_sch]
2024-02-28 Added 3D-files for connectors
    [EA2-12NJ.step, MCP23008-E_SO.step, ThePreamp-Analogue.kicad_pcb, ULN2803CDWR.STEP, c-t4040014031-000-a-3d.stp, c-t4040014041-000-a-3d.stp]
2024-03-02 Ready for production
    [ThePreamp-Analogue.kicad_pcb, ThePreamp-Analogue.kicad_sch, ThePreamp-Controller.kicad_pcb, ThePreamp-Controller.kicad_sch, bom.csv, designators.csv, positions.csv]
2024-03-03 Ready for review before production
    [PEC11r-4220f-s0024.stp, RCA Connector ALI.step, ThePreamp-Analogue.kicad_pcb, ThePreamp-Controller.kicad_pcb, esp32_dev_kit_v1_asm.stp]
2024-03-05 Started work on digital psu
    [Digital PSU.kicad_pcb, Digital PSU.kicad_sch]
2024-03-06 More work on PSU
    [Digital PSU.kicad_pcb, Digital PSU.kicad_sch]
2024-03-08 Removed +/-15V connector from analog board
    [ThePreamp-Analogue.kicad_pcb, ThePreamp-Analogue.kicad_sch, ThePreamp-Controller.kicad_pcb]
2024-03-10 Updated Template-Daughter-board to reflect changes
    [Template-Daughter-board.kicad_pcb, Template-Daughter-board.kicad_sch, ThePreamp-Controller.kicad_pcb, ThePreamp-Controller.kicad_sch]
2024-03-13 Connector placement in chassis
    [Chassis.kicad_pcb, Chassis.kicad_sch, ThePreamp-Controller.kicad_pcb]
2024-03-16 Added transformer for Digital PSU
    [Digital PSU.kicad_pcb, Digital PSU.kicad_sch]
2024-03-16 Minor updates
    [Digital PSU.kicad_pcb]
2024-03-17 Added LD1117V33 to digital psu
    [Digital PSU.kicad_pcb, Digital PSU.kicad_sch]
2024-03-17 Measurements of chassis added
    [Chassis.kicad_pcb]
2024-03-17 Added analog pcb in right position on chassis drawing
    [Chassis.kicad_pcb]
2024-03-18 Aligned IDC connector placement between controller and analog pcb
    [Chassis.kicad_pcb, ThePreamp-Analogue.kicad_pcb]
2024-03-21 Pcb dimensions
    [Chassis.kicad_pcb, Digital PSU.kicad_pcb, Digital PSU.kicad_sch, ThePreamp-Analogue.kicad_pcb, ThePreamp-Analogue.kicad_sch, ThePreamp-Controller.kicad_pcb, ThePreamp-Controller.kicad_sch]
2024-03-23 Chassis placement new draft
    [Chassis.kicad_pcb, Digital PSU.kicad_pcb, ThePreamp-Analogue.kicad_pcb, ThePreamp-Analogue.kicad_sch, ThePreamp-Controller.kicad_pcb, ThePreamp-Controller.kicad_sch]
2024-03-24 Chassis placement draft
    [Chassis.kicad_pcb, Digital PSU.kicad_pcb]
2024-03-26 Small adjustments to draft
    [Chassis.kicad_pcb, Digital PSU.kicad_pcb, Digital PSU.kicad_sch]
2024-03-26 pcb splitout
    [Chassis.kicad_pcb, Digital PSU - 8V_3.3V.kicad_pcb, Digital PSU - 8V_3.3V.kicad_sch, Digital PSU - LAdapter.kicad_pcb, Digital PSU - LAdapter.kicad_sch, Digital PSU - Transformer.kicad_pcb, Digital PSU - Transformer.kicad_sch, Digital PSU.kicad_pcb]
2024-03-26 gitignore test
    [Chassis.kicad_pcb]
2024-04-03 Updated pcb 3.3V + adjust of connectors on controller pcb
    [Digital PSU - 8V_3.3V.kicad_pcb, Digital PSU - 8V_3.3V.kicad_sch, ThePreamp-Controller.kicad_pcb, ThePreamp-Controller.kicad_sch]
2024-04-10 Moved connector on Analogue pcb
    [ThePreamp-Analogue.kicad_pcb]
2024-04-14 Ready for review (updated Digital PSU - Transformer and Controller)
    [Digital PSU - Transformer.kicad_pcb, Digital PSU - Transformer.kicad_sch, ThePreamp-Controller.kicad_pcb, ThePreamp-Controller.kicad_sch]
2024-04-25 Ready for review
    [ThePreamp-Controller.kicad_pcb, bom.csv, designators.csv, positions.csv]
2024-05-19 Last changes before ordering of pcb
    [Digital PSU - 8V_3.3V.kicad_pcb, Digital PSU - LAdapter.kicad_pcb, Digital PSU - Transformer.kicad_pcb, ThePreamp-Analogue.kicad_pcb, ThePreamp-Controller.kicad_pcb, bom.csv, designators.csv, positions.csv]
2024-06-08 Fixed display issue on start, changed IR lib
    [main.cpp]
2024-06-13 MVP version - stabilized displays
    [main.cpp]
2024-09-04 Separating digital and analog ground
    [Buffer-Opamp.kicad_sch, Daughter-Board-Muses-Op-Amp.kicad_pcb, Daughter-Board-Muses-Op-Amp.kicad_sch, ThePreamp-Analogue (Copy).kicad_sch, Volume.kicad_sch]
2024-09-12 daughter board muses + buffer
    [Daughter-Board-Muses-Op-Amp.kicad_sch]
2024-09-19 PCB Daughter board started
    [Daughter-Board-Muses-Op-Amp.kicad_pcb, Daughter-Board-Muses-Op-Amp.kicad_sch]
2024-09-26 started pcb tracks
    [Daughter-Board-Muses-Op-Amp.kicad_pcb, Daughter-Board-Muses-Op-Amp.kicad_sch]
2024-10-03 almost there with pcb again
    [Daughter-Board-Muses-Op-Amp.kicad_pcb, Daughter-Board-Muses-Op-Amp.kicad_sch]
2024-10-24 pcb update
    [Daughter-Board-Muses-Op-Amp.kicad_pcb, Daughter-Board-Muses-Op-Amp.kicad_sch, bom.csv, designators.csv, positions.csv]
2024-10-25 Footprints updated - rerouting still missing
    [Daughter-Board-Muses-Op-Amp.kicad_pcb, Daughter-Board-Muses-Op-Amp.kicad_sch]
2024-10-26 PCB ready for review
    [Daughter-Board-Muses-Op-Amp.kicad_pcb]
2024-10-31 Small adjustments ready to order.
    [Daughter-Board-Muses-Op-Amp.kicad_pcb, bom.csv, positions.csv]
2024-11-29 Muses72323 added + input selection fixed
    [main.cpp]
2024-12-09 Volume (attenuation has been fixed)
    [main.cpp]
2025-01-09 Fix of input name, volumesteps.
    [main.cpp]
2025-01-13 Function created for temperature display (empty)
2025-01-16 Add temperature read from ads1115
2025-01-20 Added visualization of temperatures
2025-02-11 Debugging of rotary encoders
2025-02-13 Added pullup resistors on D34-35 on controller pcb
    [ThePreamp-Controller.kicad_pcb, ThePreamp-Controller.kicad_sch, bom.csv, designators.csv, positions.csv]
2025-03-06 After update to Kicad 9
2025-03-06 pcb bug output relay fixed - when off output should be shorted to ground a
    [ThePreamp-Analogue.kicad_pcb, ThePreamp-Analogue.kicad_sch]
2025-04-09 Lowered SPI bus to 500kHz for Muses
2025-04-21 Fixed startup calls to setVolume
    [main.cpp]
2026-02-07 Stabilize display init - local Muses lib
    [main.cpp]
2026-02-15 Fixed output relay wiring on analog board schematic & pcb
    [ThePreamp-Analogue.kicad_pcb, ThePreamp-Analogue.kicad_sch]
2026-02-25 Added 10uF for EN pin to stabilize init of displays
    [ThePreamp-Controller.kicad_pcb, ThePreamp-Controller.kicad_sch]
2026-09-19 Implemented balance setting (click right encoder to change)
2026-09-19 Implemented trigger control and fixed settings.html
    [display_controller.cpp, display_controller.h, main.cpp]
2026-09-19 Increase security: do not leak wifi password via endpoints
    [controller_config.cpp, wifi_support.cpp]
2026-09-21 Added power toggle to remote
2026-09-23 Added mute/unmute to the web remote + fixed screen saver reset on post endpoints used by remote
    [display_controller.cpp, main.cpp, wifi_support.cpp]
2026-10-04 Fix volume display at power up
    [main.cpp]
2026-10-04 Fixed warnings about deprecated functions from ArduinoJson
    [controller_config.cpp]
2026-10-22 Add build-date info page and push-changes skill
    - Add second info screen showing firmware and filesystem build dates; switch pages with left/right on the info screen
    - Stamp build time via build_stamp.py (include/build_info.h and data/buildinfo.txt, both git-ignored)
    - Add push-changes skill
2026-10-22 Only build and upload firmware/filesystem in flash skill when changed
    - Hash inputs and skip unchanged builds and per-target uploads
    - Add -Force switch, use nobuild for USB uploads
    - Rename Pio helper to Invoke-Pio to avoid recursion
2026-10-22 Keep display CS lines high at boot to avoid mirrored screens
    - Pull up and deselect all SPI CS pins and display resets first in setup()
    - Clear both displays after init
2026-10-28 Queue web requests for loop() and update README
    - Web handlers queue input/volume/mute; loop() applies them to avoid concurrent SPI access (display mirroring)
    - README documents request queue, mute icon, endpoints, build/flash/test
    - push-changes skill updates README before committing
2026-10-28 Add webcam display tests and fix display/request races
    - Add display-tests.ps1: webcam/OCR checks of input name, volume (steps/dB/hidden), mute, WiFi/temperature icons, screen saver, standby and start-up
    - capture_display.py: 1920x1080 capture, --analyze mode with per-display crops and lit-pixel metrics
    - Fix request queue race in processPendingRequests (portMUX)
    - Clear left display when DisplaySelectedInput is off
    - Add preamp-webcam-display-test skill; update TESTING.md and README
2026-10-31 Add interactive webcam calibration with automatic validity check
    - calibrate_camera.py: live view to mark both displays, saves ROIs, camera index and reference frame
    - --check validates the saved calibration; test-preamp.ps1 -IncludeDisplay runs it and starts calibration if invalid
    - Displays are woken via the API before and during calibration
    - capture_display.py uses the saved calibration as defaults
2026-10-31 Improve webcam calibration instructions
    Clarify the two display boxes and make calibration guidance easier to read.
2026-10-31 Exit info screen with the same left encoder click that enters it
    - Info mode now exits on KEY_INFO (encoder 2 click) instead of KEY_SELECT
    - Document encoder and IR key mapping in README
2026-10-31 Replace U8g2 with local SH1122 greyscale driver
    - New lib/SH1122 driver: 4bpp buffer, 16 grey levels, hardware SPI
    - Anti-aliased logo and input name/volume fonts (generator scripts in tools/)
    - Validate input names against font character range (settings page and API)
    - Update 130x64 logo PNG and README
